torosky92/ChrisV2/Fotos - ChrisV2/Version 2/IMG-20191017-WA0040.jpg

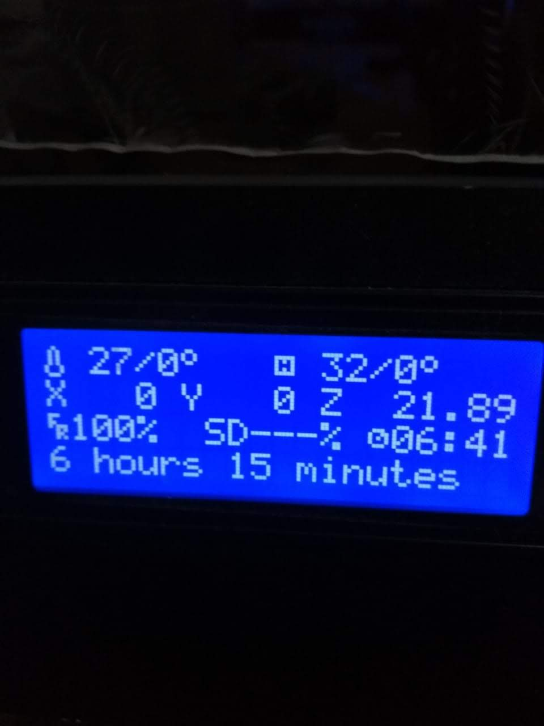
Fotos - ChrisV2/Version 2/IMG-20191017-WA0040.jpg
