torosky92/ChrisV2/Fotos - ChrisV2/Version 2/IMG-20191020-WA0022.jpg

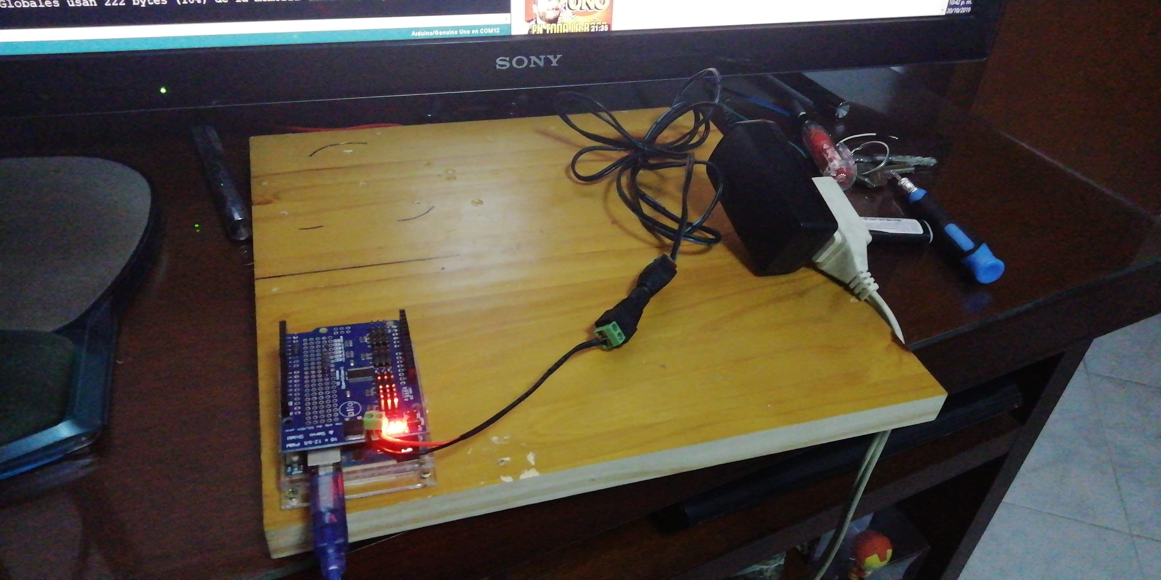
Fotos - ChrisV2/Version 2/IMG-20191020-WA0022.jpg
