torosky92/ChrisV2/Fotos - ChrisV2/Version 2/IMG_20191004_101258.jpg

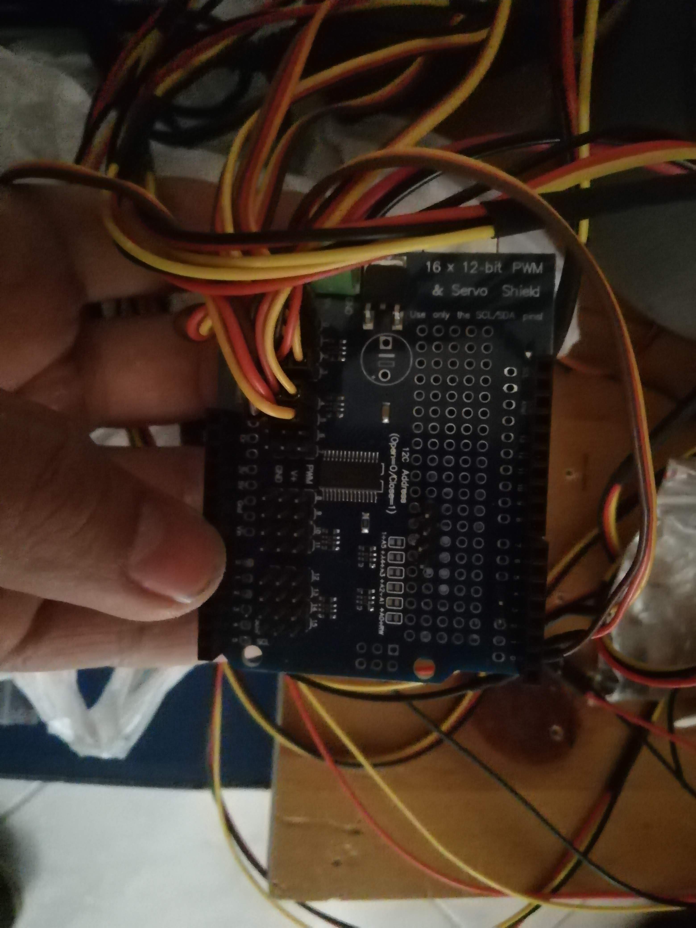
Fotos - ChrisV2/Version 2/IMG_20191004_101258.jpg
