torosky92/ChrisV2/Fotos - ChrisV2/Version 2/IMG_20191017_102911.jpg

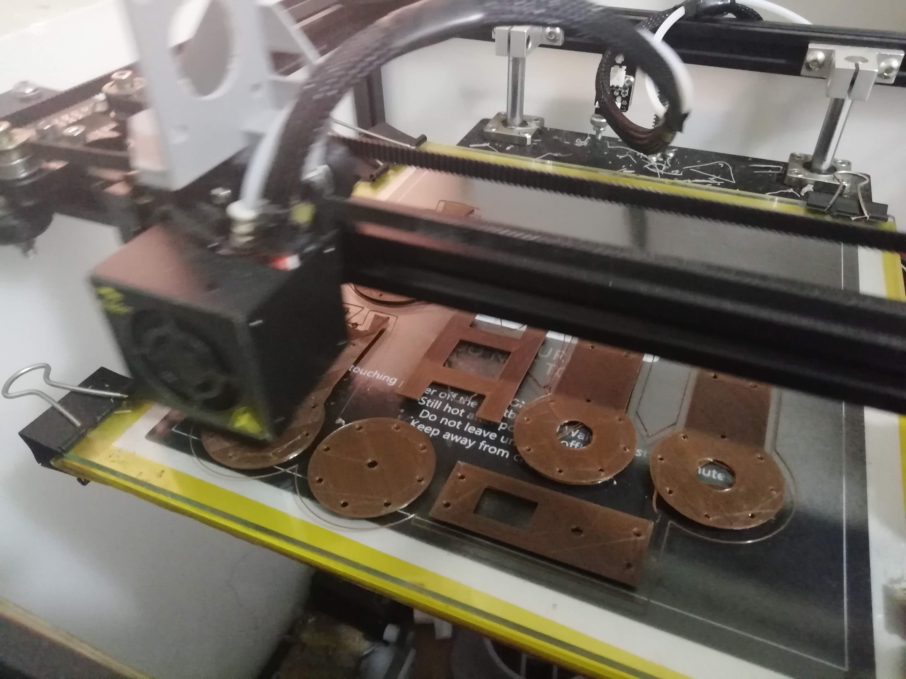
Fotos - ChrisV2/Version 2/IMG_20191017_102911.jpg
