torosky92/ChrisV2/Fotos - ChrisV2/Version 2/IMG_20191020_154016.jpg

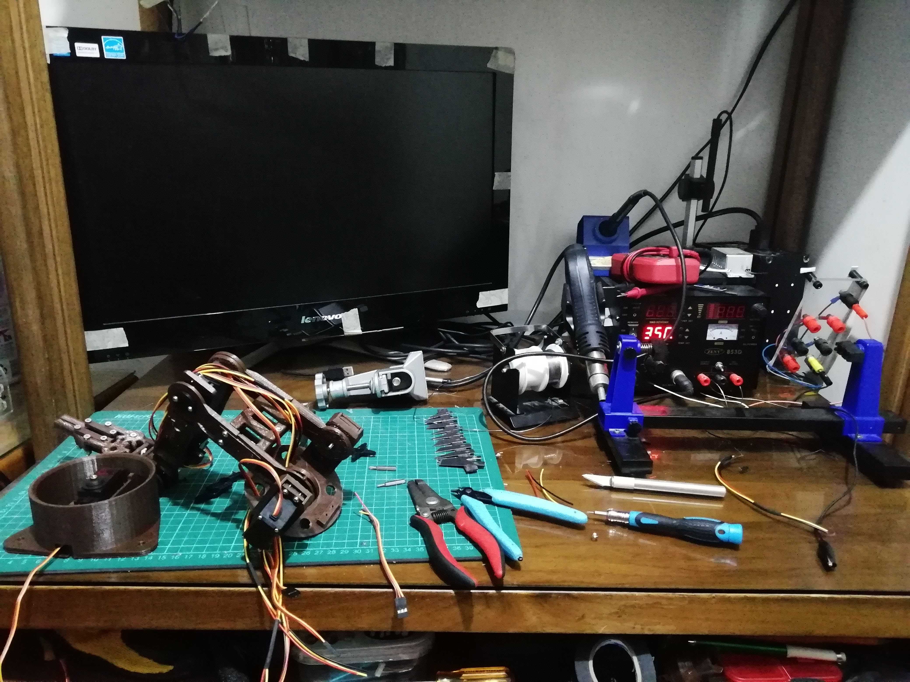
Fotos - ChrisV2/Version 2/IMG_20191020_154016.jpg
