torosky92/ChrisV2/Fotos - ChrisV2/Version 2/WhatsApp Image 2019-10-19 at 11.20.56 (1).jpeg

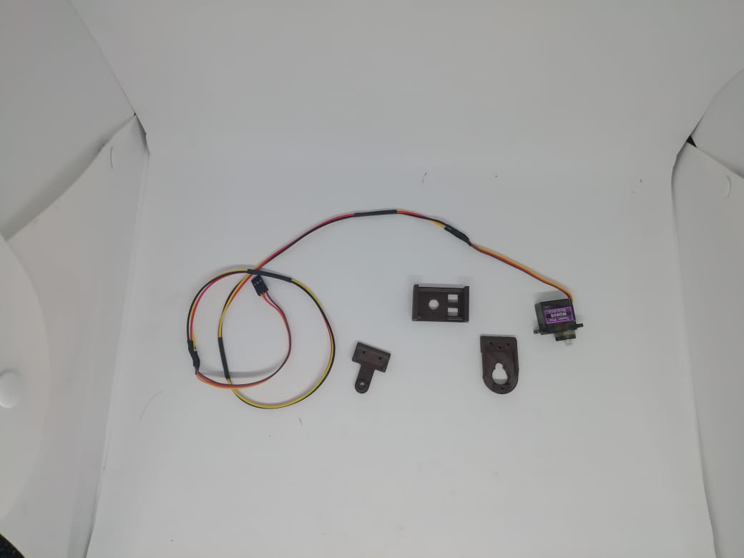
Fotos - ChrisV2/Version 2/WhatsApp Image 2019-10-19 at 11.20.56 (1).jpeg
