torosky92/ChrisV2/Fotos - ChrisV2/Version 2/WhatsApp Image 2019-10-19 at 11.21.00.jpeg

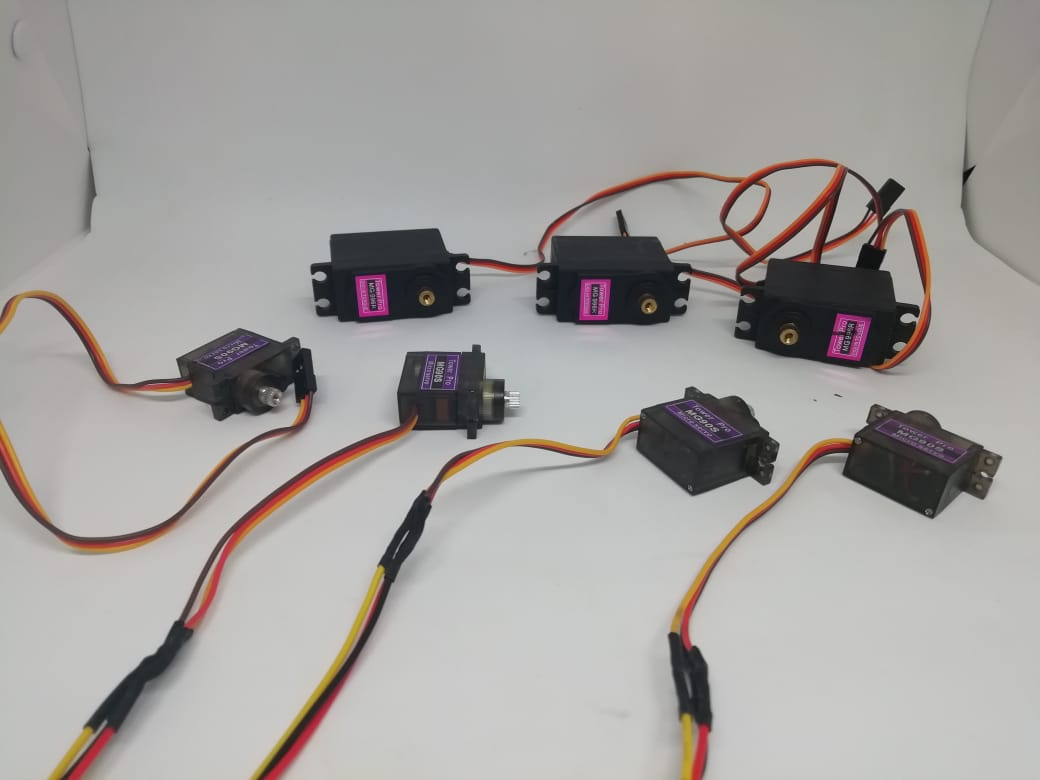
Fotos - ChrisV2/Version 2/WhatsApp Image 2019-10-19 at 11.21.00.jpeg
