torosky92/ChrisV2/Fotos - ChrisV2/Version 2/WhatsApp Image 2019-10-20 at 08.26.20 (2).jpeg

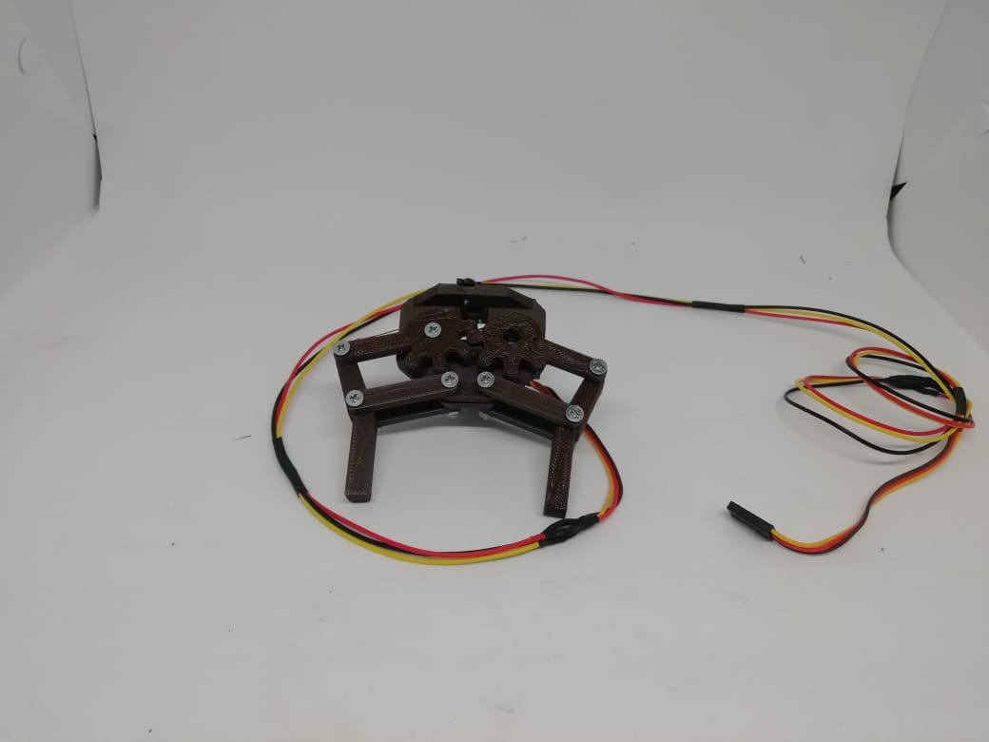
Fotos - ChrisV2/Version 2/WhatsApp Image 2019-10-20 at 08.26.20 (2).jpeg
