torosky92/ChrisV2/Fotos - ChrisV2/Version 2/WhatsApp Image 2019-10-24 at 18.39.17.jpeg

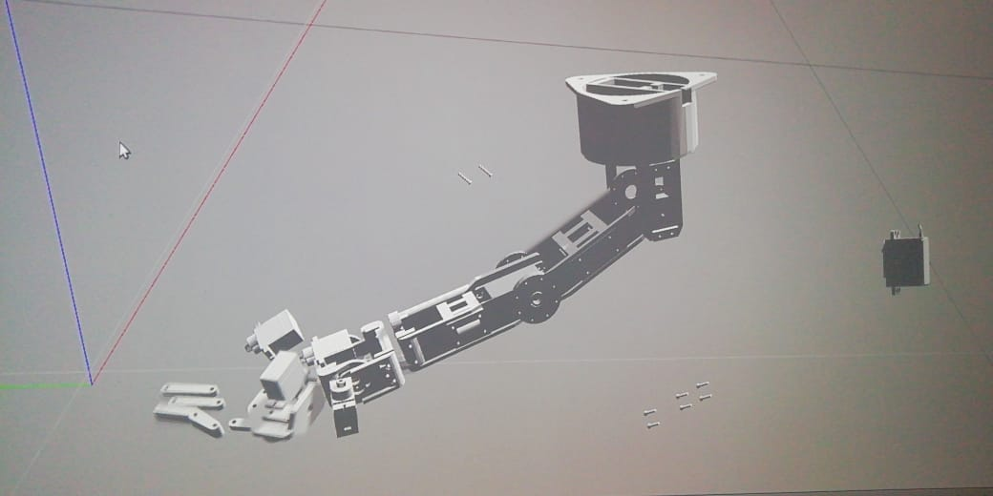
Fotos - ChrisV2/Version 2/WhatsApp Image 2019-10-24 at 18.39.17.jpeg
