torosky92/ChrisV2/Fotos - ChrisV2/Version 2/WhatsApp Image 2019-10-24 at 19.53.18.jpeg

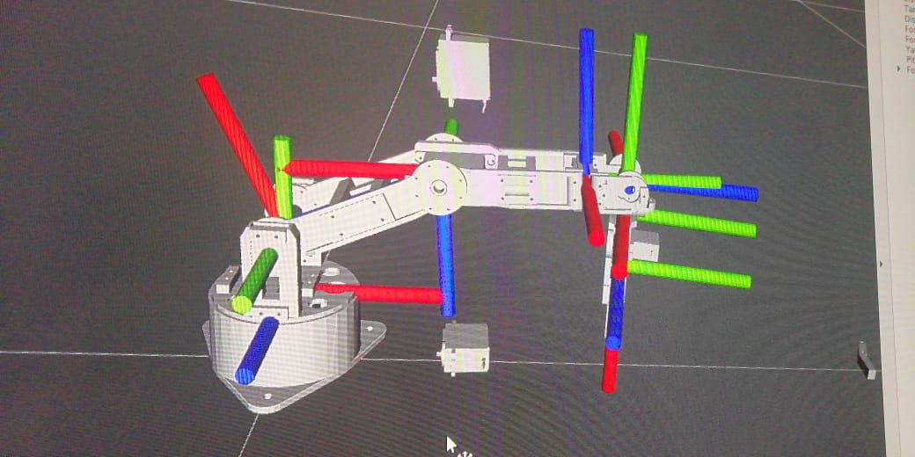
Fotos - ChrisV2/Version 2/WhatsApp Image 2019-10-24 at 19.53.18.jpeg
