torosky92/ChrisV2/Costo de Brazo 2019.xlsx

Sheet: Costo
COSTO DE BRAZO ROBOTICO CHRISTIAN
ARTICULO | CANT | VALOR U | VALOR TOTAL | Se tiene
Servomotor estandar de alto torque MG996R | 3 | $25000.00 | $75000.00 | X
Servomotor Mini MG90S | 5 | $15000.00 | $75000.00 | X
Servomotor Mini SG90 | 1 | $10000.00 | $10000.00 | X
Impresión 3d por hora y material | 31 | $4900.00 | $151900.00 | X
Tornillo de métrica M3x25mm | 10 | $60.00 | $600.00 | X
Tuerca de métrica M3 | 10 | $20.00 | $200.00 | X
Tornillo de métrica M2x6mm | 50 | $500.00 | $25000.00 | X
Tuerca de métrica M2 | 50 | $80.00 | $4000.00 | X
Cable amarillo AWG20 1m | 5 | $900.00 | $4500.00 | X
Cable rojo AWG20 1m | 5 | $900.00 | $4500.00 | X
Cable negro AWG20 1m | 5 | $900.00 | $4500.00 | X
Termo encogible 1m | 2 | $500.00 | $1000.00 | X
Shield para servomotores | 1 | $45000.00 | $45000.00 | X
Jack Chasis para voltaje DC 5*2.1mm | 1 | $600.00 | $600.00 | X
Arduino uno | 1 | $65000.00 | $65000.00 | X
Adaptador de voltaje 5V 3A | 1 | $13000.00 | $13000.00 | X
Header hembra 40 pines | 1 | $700.00 | $700.00 | X
Estaño | 1 | $5000.00 | $5000.00 | X
MDF 5mm de espesor 10cmX10cm | 1 | $10000.00 | $10000.00 | X
arandelas M3 | 1 | $500.00 | $500.00 | X
 |  | TOTAL | $496000.00

Sheet: Descripcion
CONTROL DEL BRAZO
VARIABLE | DESCRIPCIÓN | CONTROL | ARTICULACIÓN | LIMITES
 |  |  |  | RAD MIN | RAD MAX | FUERZA | VELOCIDAD
S1 | Giro de antebrazo con servo MG996R | ROS | 1 | 0 | 3.14 | 1000 | 0.5
S2 | Subir o Bajar de antebrazo con servo MG996R | ROS | 2 | -1.65 | 1.3 | 1000 | 0.5
S3 | Subir o Bajar de brazo con servo MG996R | ROS | 3 | -1.65 | 1.65 | 1000 | 0.5
S4 | Giro de brazo con servo MG90S | ROS | 4 | 0 | 3.14 | 1000 | 0.5
S5 | Subir o Bajar de Garra con servo MG90S | ROS | 5 | -1.5 | 1.5 | 1000 | 0.5
S6 | Giro de Garra con servo MG90S | ROS | 6 | 0 | 3.14 | 1000 | 0.5
S7 | Abrir o Cerrar la Garra con servo MG90S | ROS | 7 | -0.6 | 0 | 1000 | 0.5
S8 | Dispensador de las bolas de la rampa con servo SG90 | Arduino | 0 | 0 | 1.57 | 500 | 0.5
