torosky92/ChrisV2/SolidWorks/Ensamblaje-Eslabon5.SLDASM

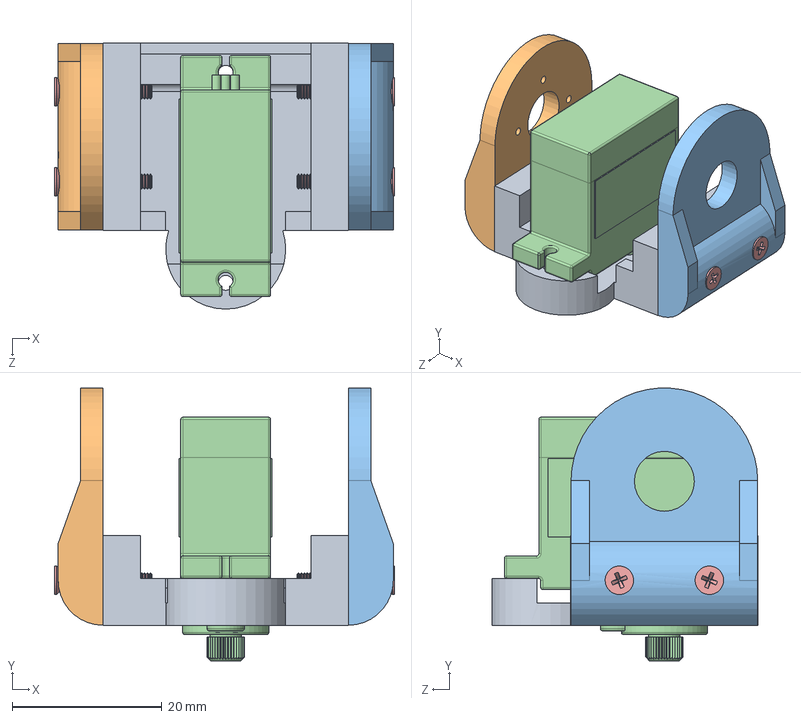
[picture p61: CAD file, 2020-05-09]
SolidWorks/Ensamblaje-Eslabon5.SLDASM
45.3 x 36.4 x 35.5 mm
Eslabon5A-Servo
Eslabon5B
Eslabon5C
MG90S-Servo
flat head screw_am x 4
