torosky92/ChrisV2/SolidWorks/Ensamblaje-Eslabon4.SLDASM

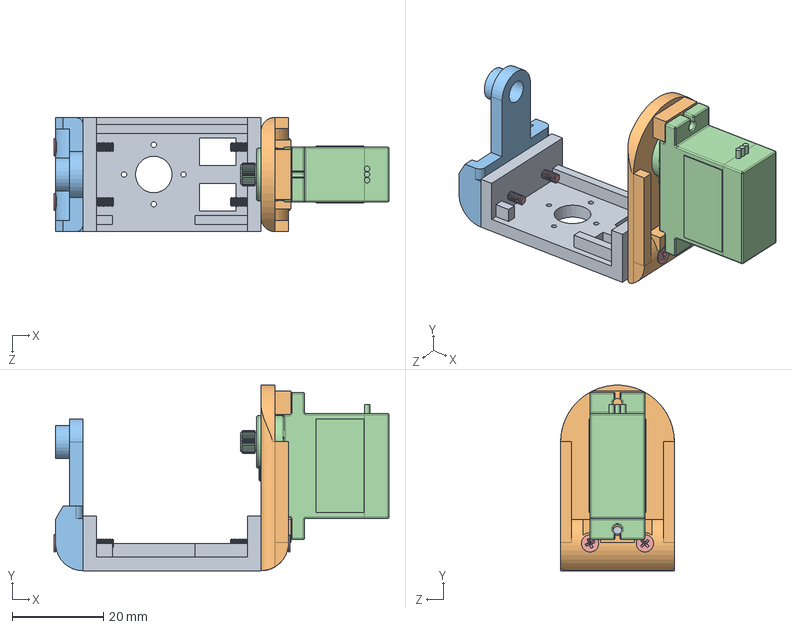
[picture p62: CAD file, 2020-05-09]
SolidWorks/Ensamblaje-Eslabon4.SLDASM
73.3 x 40.6 x 25.0 mm
Eslabon4A
Eslabon4B
Eslabon4C
MG90S-Servo
flat head screw_am x 4
