torosky92/ChrisV2/SolidWorks/Ensamblaje-Eslabon2AB.SLDASM

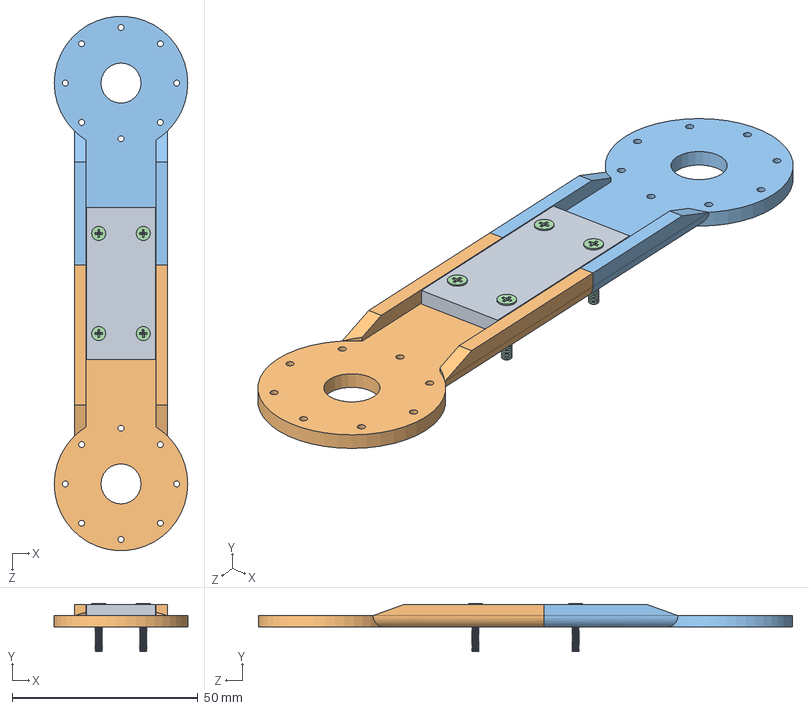
[picture p63: CAD file, 2020-05-09]
SolidWorks/Ensamblaje-Eslabon2AB.SLDASM
36.0 x 13.0 x 143.9 mm
Agarre-Eslabon2AyB
Eslabon2A
Eslabon2B
flat head screw_am x 4
