torosky92/ChrisV2/SolidWorks/Ensamblaje-Garra.SLDASM

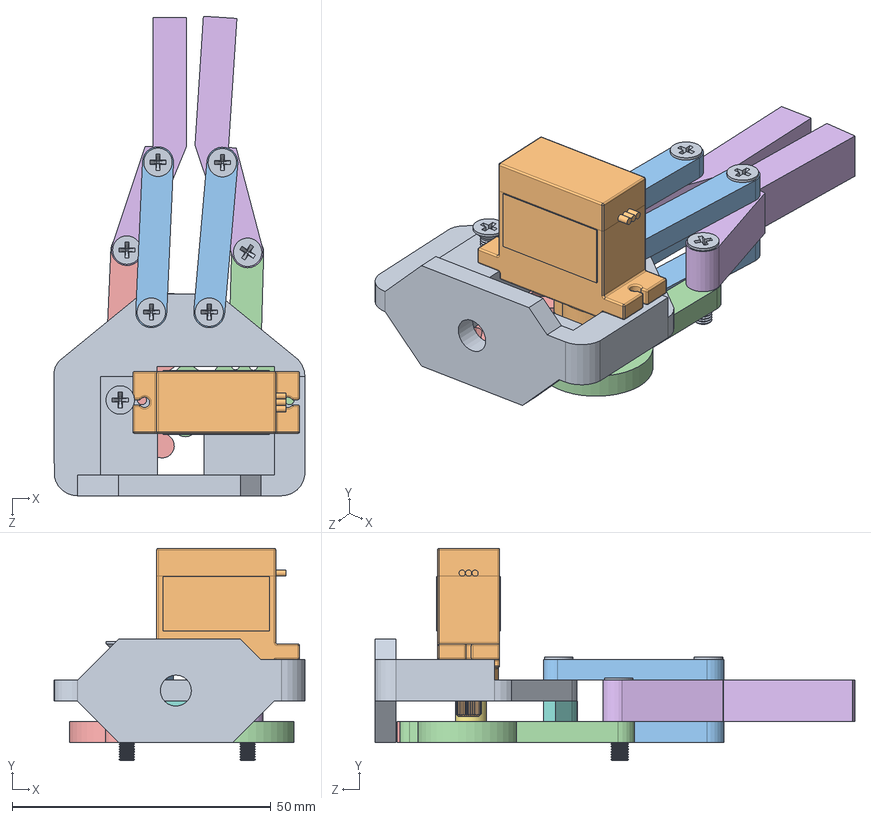
[picture p64: CAD file, 2020-05-09]
SolidWorks/Ensamblaje-Garra.SLDASM
48.5 x 41.0 x 92.7 mm
Base-De-Garra
MG90S-Servo
Conector-Garra1 x 4
Engranaje2-Garra
Engranaje-Garra
Pinza-Garra x 2
Separador-Engrane-Base
Soporte-Garra
flat head screw_am x 7
