torosky92/ChrisV2/SolidWorks/Ensamblaje-Eslabon2.SLDASM

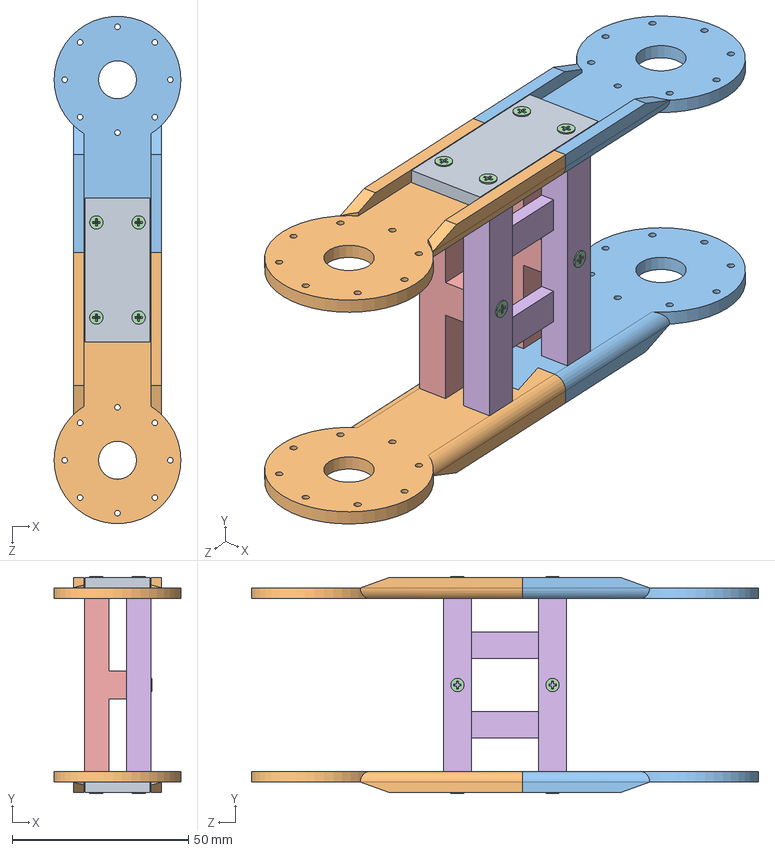
[picture p65: CAD file, 2020-05-09]
SolidWorks/Ensamblaje-Eslabon2.SLDASM
36.0 x 61.7 x 143.9 mm
Agarre-Eslabon2AyB x 2
Eslabon2A x 2
Eslabon2B x 2
flat head screw_am x 10
Conexion-Eslabones2
Conexion-Eslabones22
