torosky92/ChrisV2/SolidWorks/Ensamblaje-Eslabon1.SLDASM

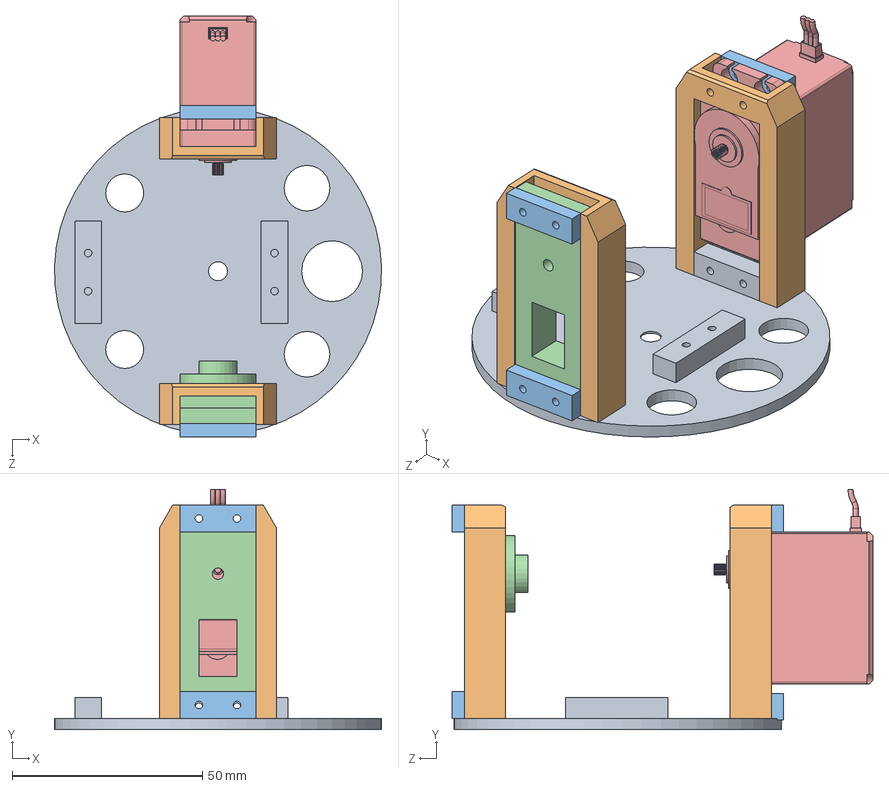
[picture p66: CAD file, 2020-05-09]
SolidWorks/Ensamblaje-Eslabon1.SLDASM
85.9 x 63.2 x 110.6 mm
Tapa-Base
Agarre-Servo1 x 2
Anclaje-Servo1 x 4
Soporte-Tama-Servo
MG996R-Servo
