torosky92/ChrisV2/SolidWorks/Ensamblaje-Eslabon3.SLDASM

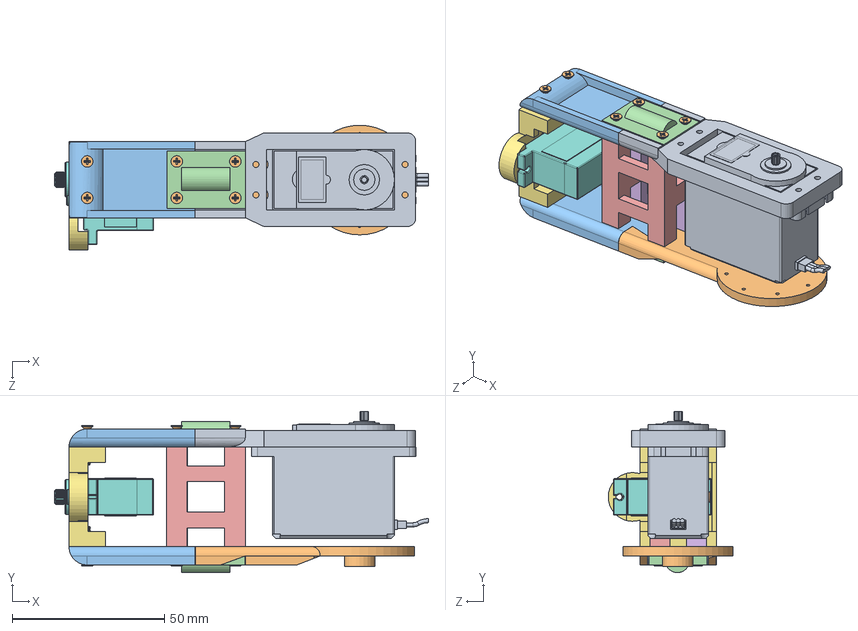
[picture p67: CAD file, 2020-05-09]
SolidWorks/Ensamblaje-Eslabon3.SLDASM
122.8 x 53.0 x 40.9 mm
Eslabon3A-Servo
Eslabon3B
Eslabon3C x 2
Eslabon3D x 2
Eslabon3E1
Eslabon3E2
Eslabon3F-Servo
MG90S-Servo
MG996R-Servo
flat head screw_am x 14
