torosky92/ChrisV2/SolidWorks/Ensamblaje-Base.SLDASM

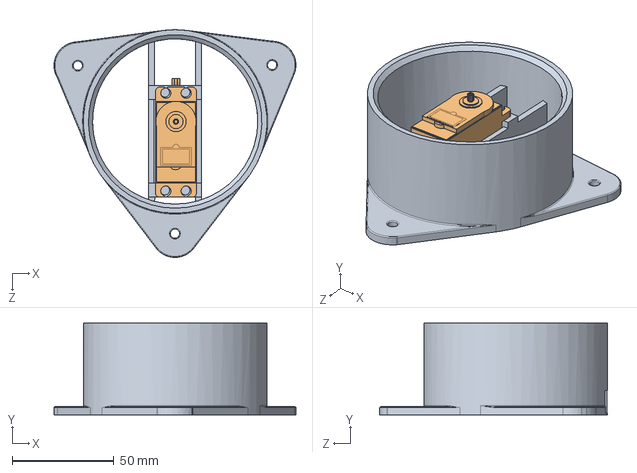
[picture p68: CAD file, 2020-05-09]
SolidWorks/Ensamblaje-Base.SLDASM
118.6 x 45.0 x 111.6 mm
BaseBrazoMG995
MG996R-Servo
