torosky92/ChrisV2/SolidWorks/Ensamblaje-Final.SLDASM

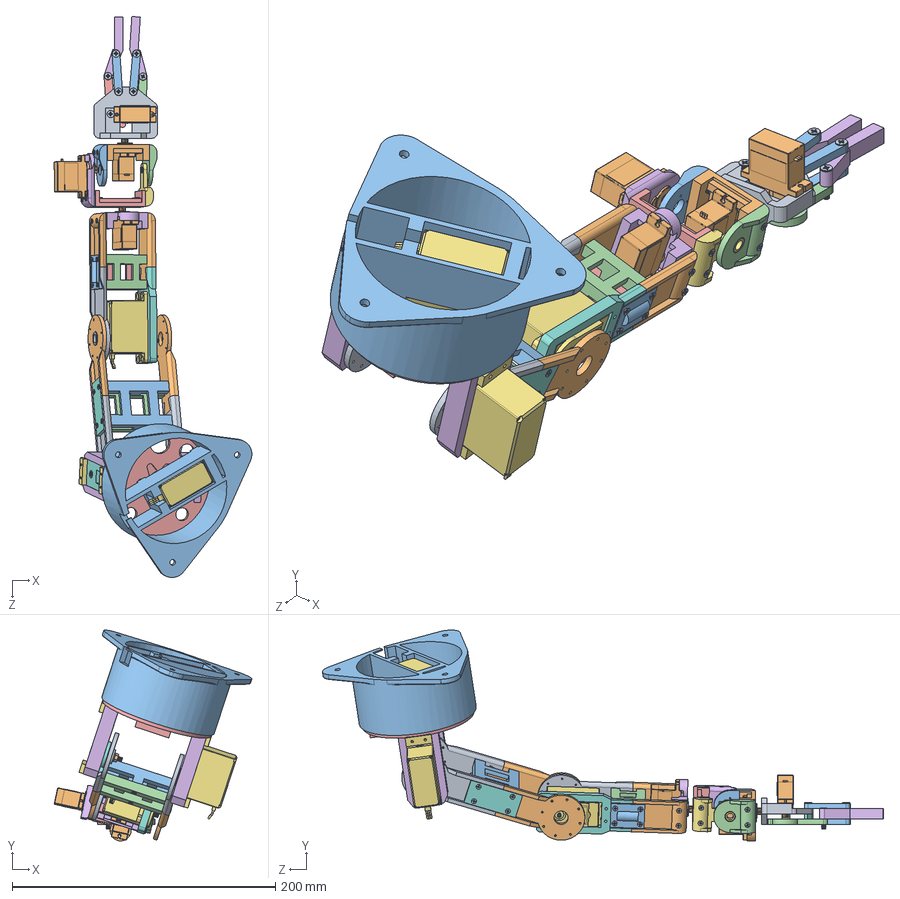
[picture p69: CAD file, 2020-05-09]
SolidWorks/Ensamblaje-Final.SLDASM
150.3 x 160.4 x 426.6 mm
Base-De-Garra
MG90S-Servo x 4
Conector-Garra1 x 4
Engranaje2-Garra
Engranaje-Garra
Pinza-Garra x 2
Separador-Engrane-Base
Soporte-Garra
flat head screw_am x 40
Eslabon5A-Servo
Eslabon5B
Eslabon5C
Eslabon4A
Eslabon4B
Eslabon4C
Eslabon3A-Servo
Eslabon3B
Eslabon3C x 2
Eslabon3D x 2
Eslabon3E1
Eslabon3E2
Eslabon3F-Servo
MG996R-Servo x 3
Agarre-Eslabon2AyB x 2
Eslabon2A x 2
Eslabon2B x 2
Conexion-Eslabones2
Conexion-Eslabones22
Tapa-Base
Agarre-Servo1 x 2
Anclaje-Servo1 x 4
Soporte-Tama-Servo
flat washer narrow_am x 2
hex nut style 1_am
BaseBrazoMG995
