torosky92/ChrisV2/arm6/meshes/link1.STL

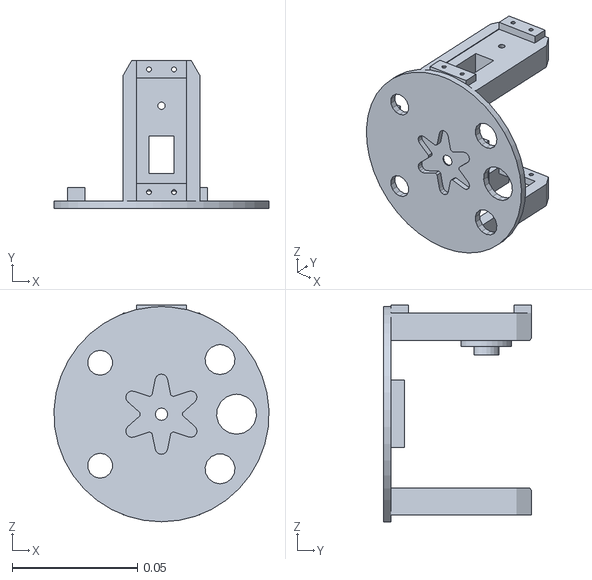
[picture p70: CAD file, 2020-05-09]
arm6/meshes/link1.STL
0.0859 x 0.059 x 0.0865
