torosky92/ChrisV2/Codigo ROS/Control_ws/install/share/arm6/meshes/link3.STL

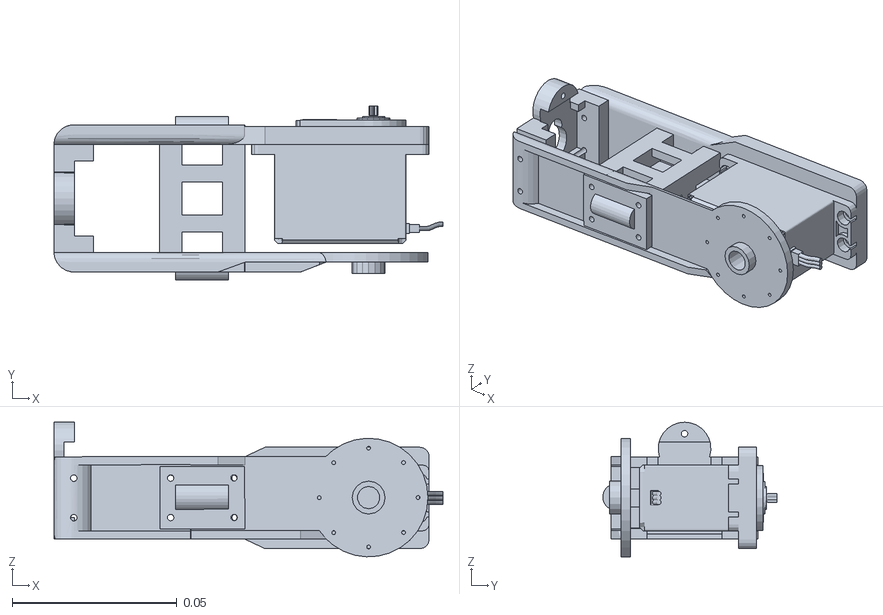
[picture p71: CAD file, 2020-05-09]
Codigo ROS/Control_ws/install/share/arm6/meshes/link3.STL
0.118 x 0.0529 x 0.0409
