torosky92/ChrisV2/Codigo ROS/Control_ws/src/arm6/meshes/link7.STL

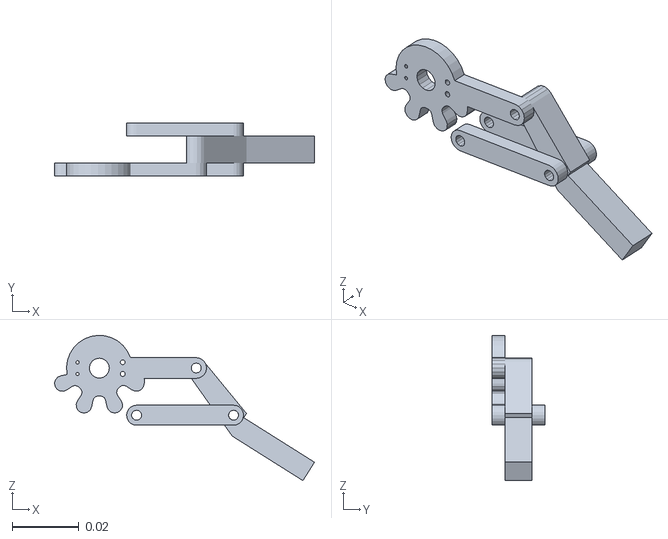
[picture p72: CAD file, 2020-05-09]
Codigo ROS/Control_ws/src/arm6/meshes/link7.STL
0.0778 x 0.016 x 0.0435
