torosky92/ChrisV2/SolidWorks/BaseBrazoMG995.SLDPRT

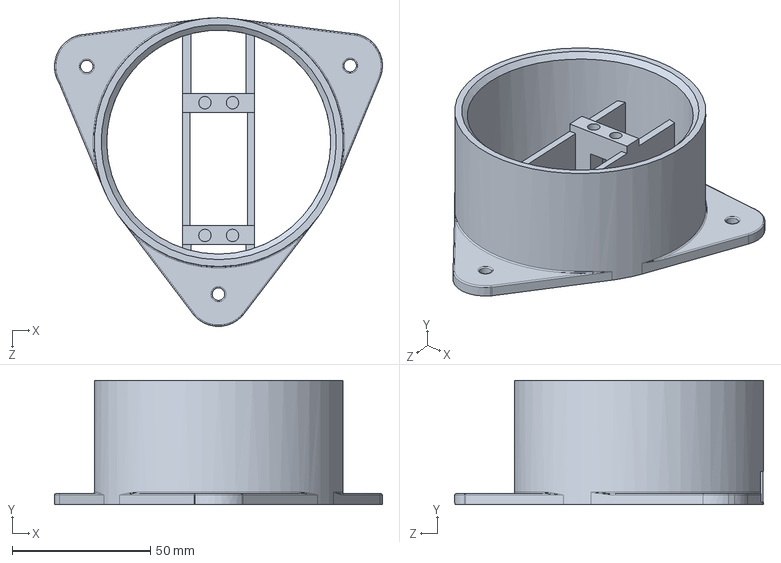
[picture p73: CAD file, 2020-05-09]
SolidWorks/BaseBrazoMG995.SLDPRT
118.6 x 45.0 x 111.6 mm
