torosky92/ChrisV2/SolidWorks/Electronica/MG90S-Servo.SLDPRT

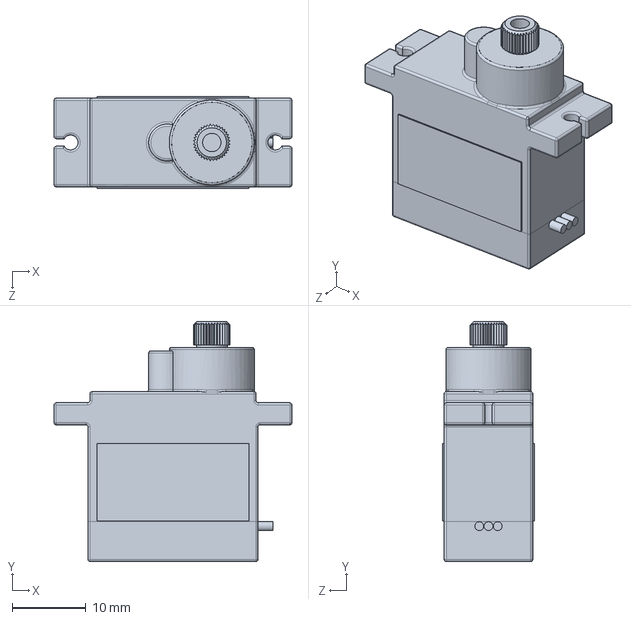
[picture p74: CAD file, 2020-05-09]
SolidWorks/Electronica/MG90S-Servo.SLDPRT
32.2 x 32.5 x 12.4 mm
