torosky92/ChrisV2/arm6/meshes/link6.STL

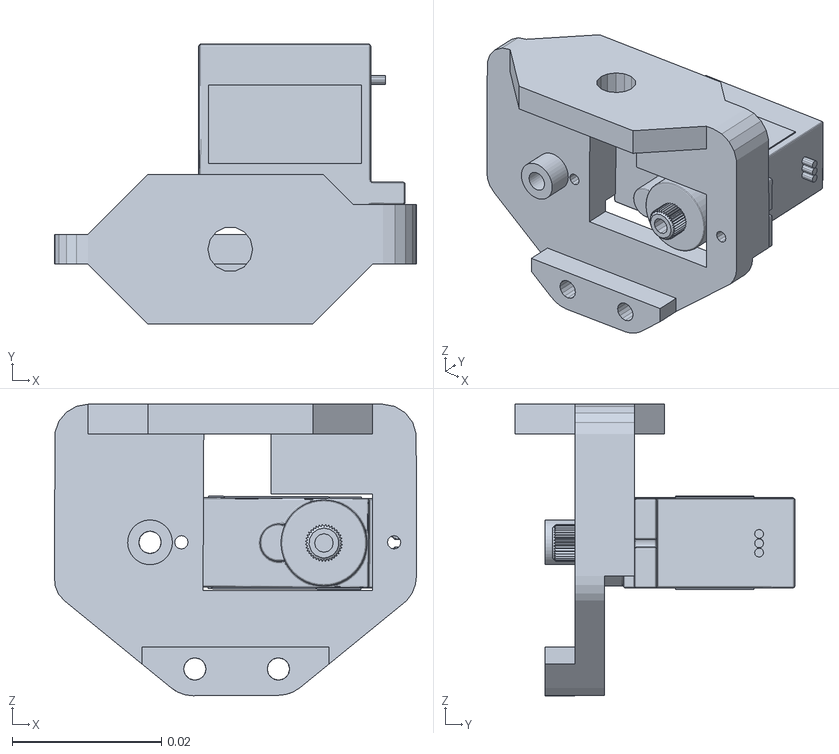
[picture p75: CAD file, 2020-05-09]
arm6/meshes/link6.STL
0.0485 x 0.0375 x 0.0391
