torosky92/ChrisV2/Codigo ROS/Control_ws/install/share/arm6/meshes/link2.STL

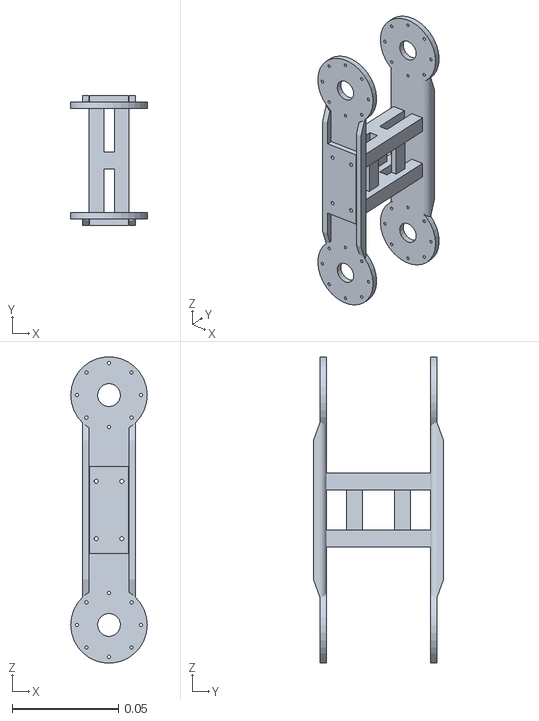
[picture p76: CAD file, 2020-05-09]
Codigo ROS/Control_ws/install/share/arm6/meshes/link2.STL
0.036 x 0.0611 x 0.144
