torosky92/ChrisV2/Codigo ROS/Control_ws/src/arm6/meshes/link5.STL

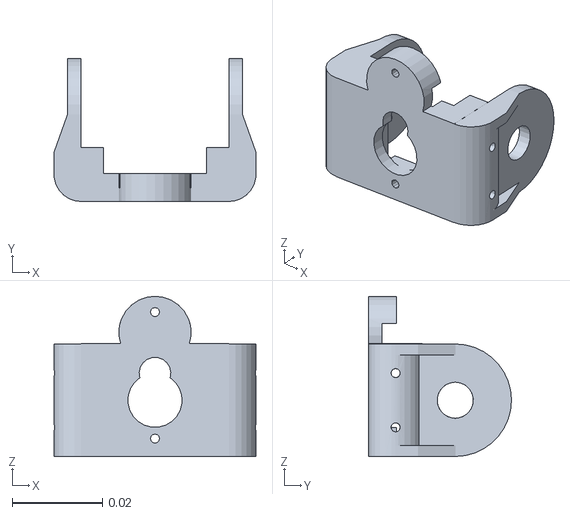
[picture p77: CAD file, 2020-05-09]
Codigo ROS/Control_ws/src/arm6/meshes/link5.STL
0.0447 x 0.0316 x 0.0355
