torosky92/ChrisV2/SolidWorks/Electronica/MG996R-Servo.SLDPRT

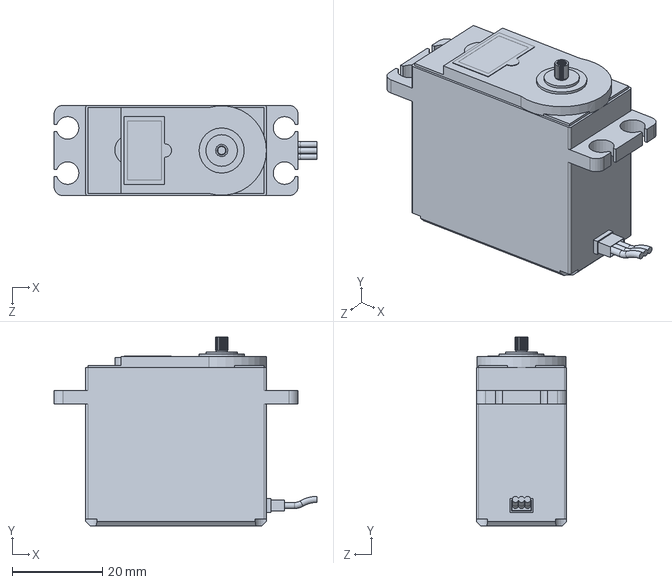
[picture p78: CAD file, 2020-05-09]
SolidWorks/Electronica/MG996R-Servo.SLDPRT
58.2 x 41.8 x 20.0 mm
