torosky92/ChrisV2/arm6/meshes/base_link.STL

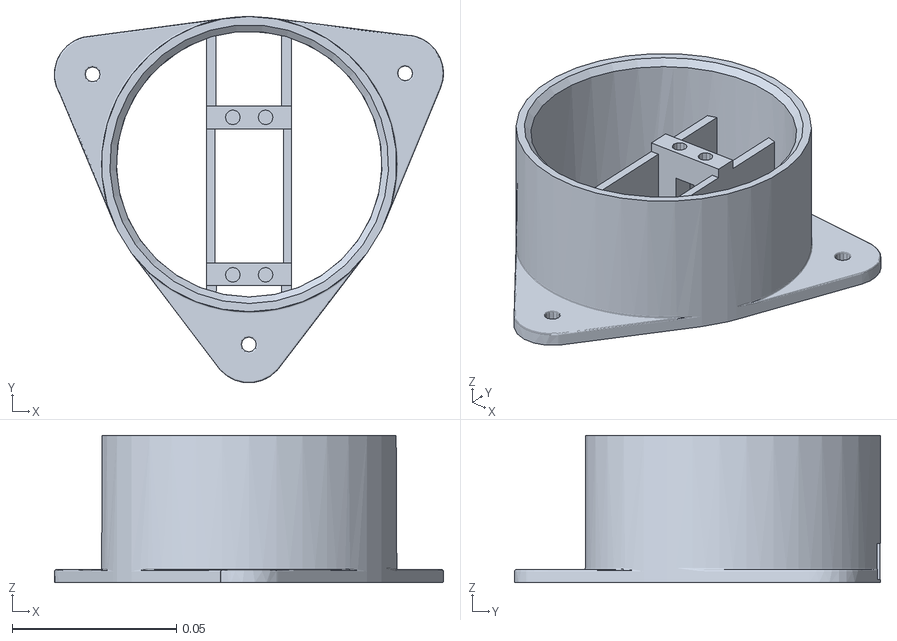
[picture p80: CAD file, 2020-05-09]
arm6/meshes/base_link.STL
0.119 x 0.112 x 0.045
