torosky92/ChrisV2/SolidWorks/Anclaje-Servo1.SLDPRT

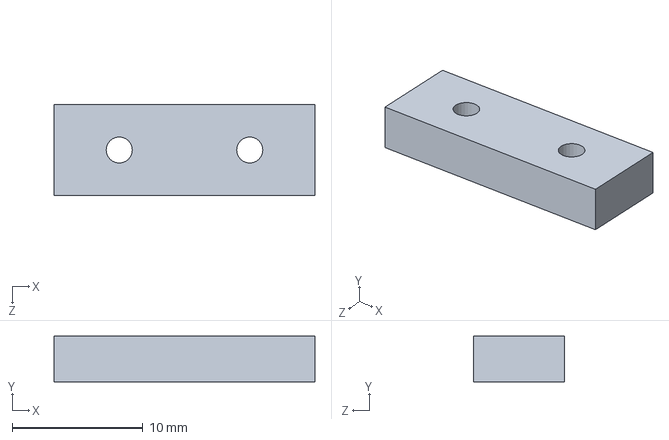
[picture p81: CAD file, 2020-05-09]
SolidWorks/Anclaje-Servo1.SLDPRT
20.0 x 3.50 x 7.00 mm
