torosky92/ChrisV2/Codigo ROS/Control_ws/install/share/arm6/meshes/link4.STL

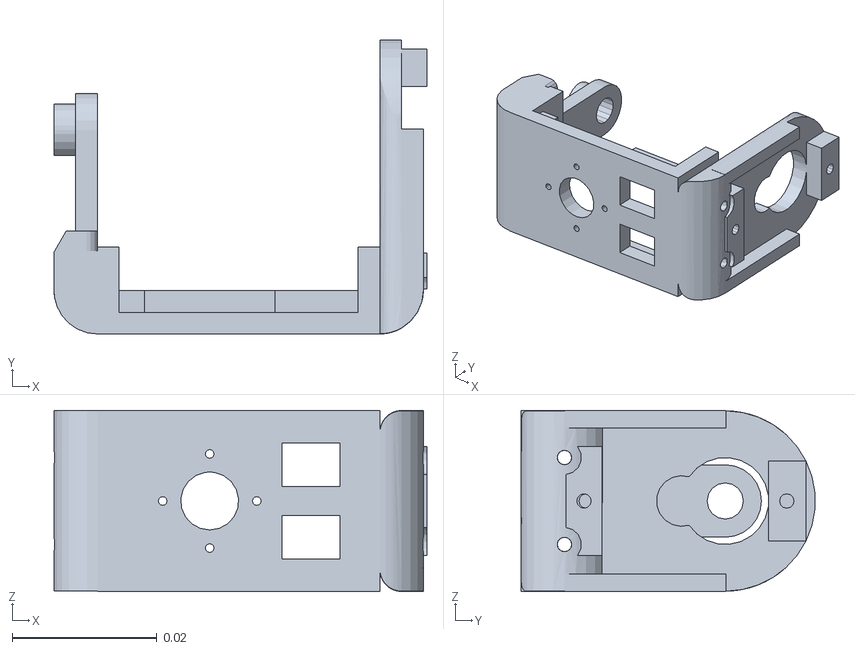
[picture p82: CAD file, 2020-05-09]
Codigo ROS/Control_ws/install/share/arm6/meshes/link4.STL
0.0515 x 0.0406 x 0.025
