torosky92/ChrisV2/SolidWorks/Pinza-Garra.SLDPRT

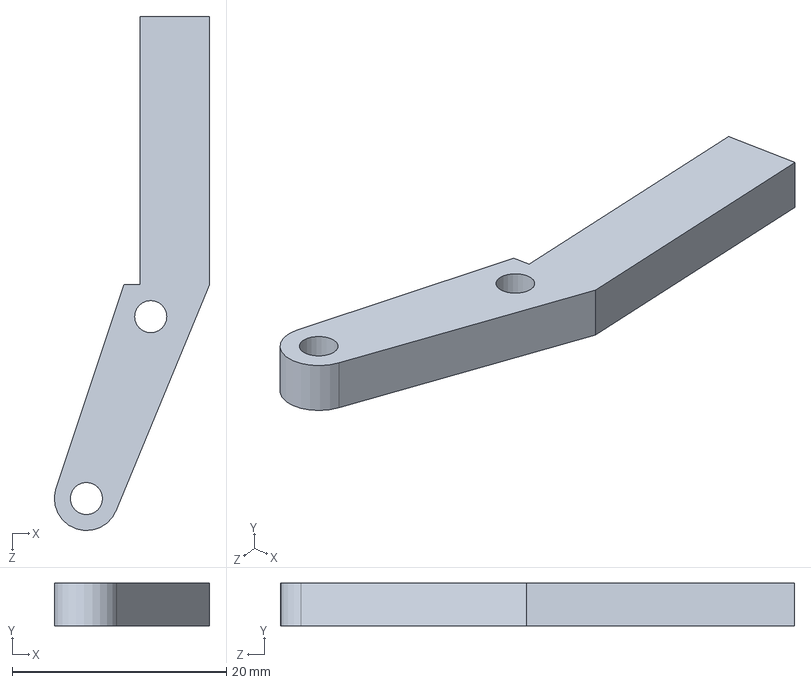
[picture p83: CAD file, 2020-05-09]
SolidWorks/Pinza-Garra.SLDPRT
14.5 x 4.00 x 48.0 mm
