torosky92/ChrisV2/SolidWorks/Eslabon5B.SLDPRT

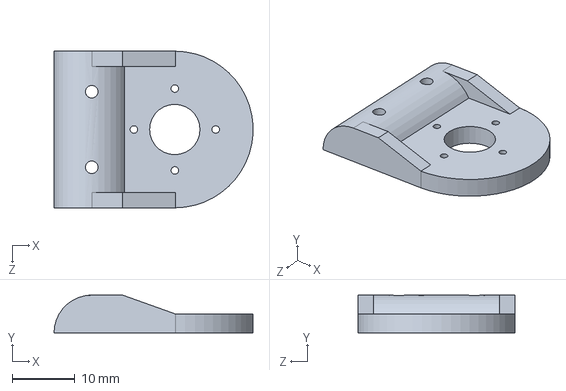
[picture p84: CAD file, 2020-05-09]
SolidWorks/Eslabon5B.SLDPRT
31.6 x 6.00 x 24.9 mm
