torosky92/ChrisV2/SolidWorks/Agarre-Eslabon2AyB.SLDPRT

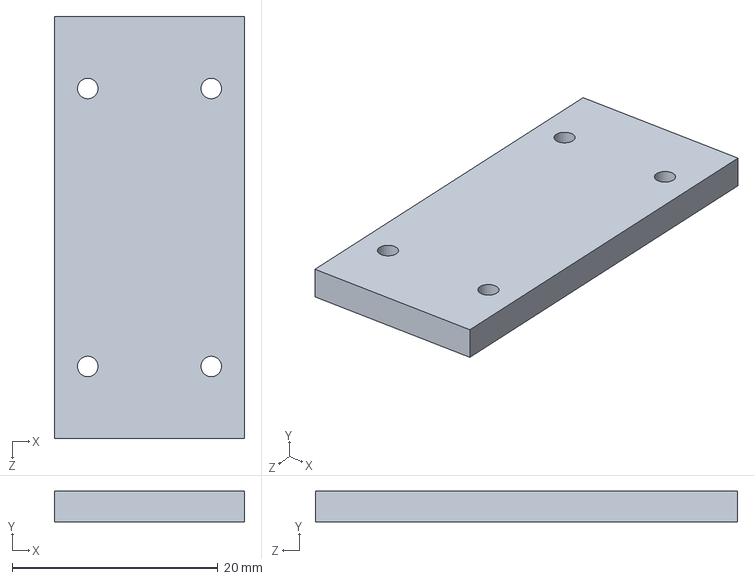
[picture p85: CAD file, 2020-05-09]
SolidWorks/Agarre-Eslabon2AyB.SLDPRT
18.5 x 3.00 x 41.0 mm
