torosky92/ChrisV2/SolidWorks/Eslabon3F-Servo.SLDPRT

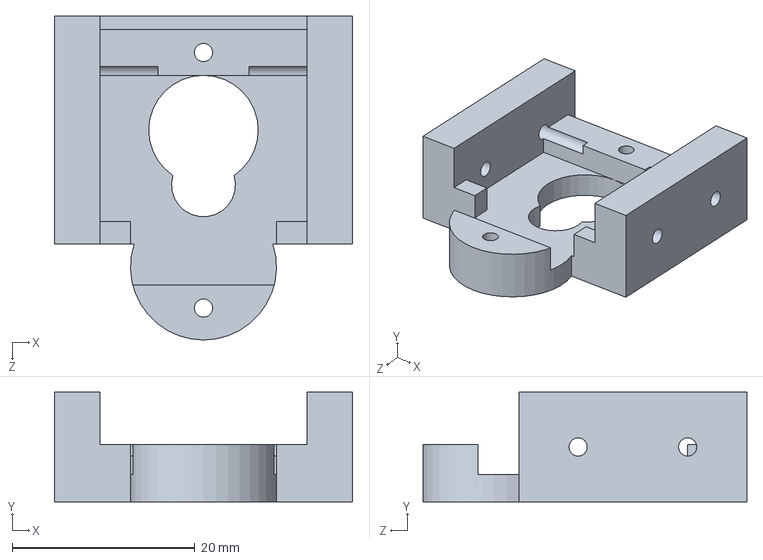
[picture p86: CAD file, 2020-05-09]
SolidWorks/Eslabon3F-Servo.SLDPRT
32.7 x 12.0 x 35.5 mm
