torosky92/ChrisV2/arm6/meshes/link8.STL

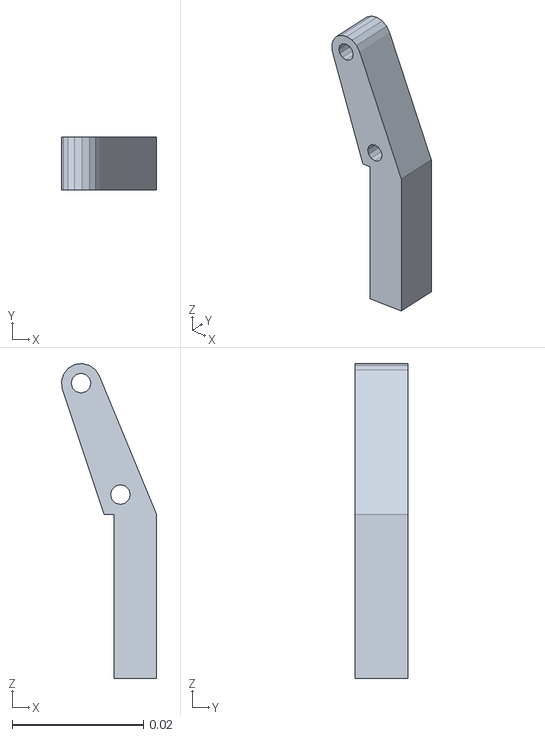
[picture p87: CAD file, 2020-05-09]
arm6/meshes/link8.STL
0.0145 x 0.008 x 0.048
