torosky92/ChrisV2/SolidWorks/Tapa-Base.SLDPRT

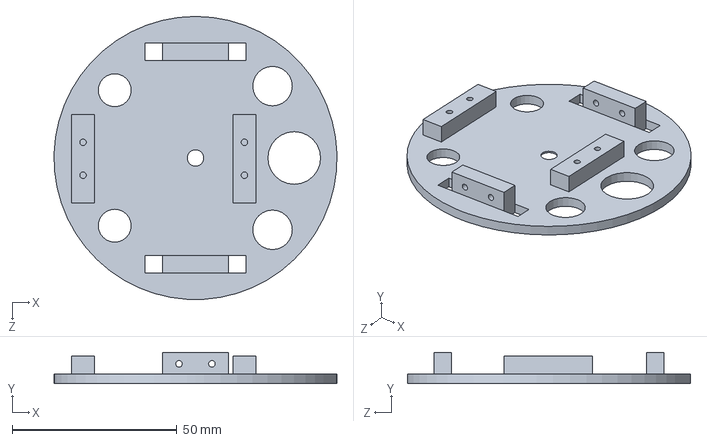
[picture p88: CAD file, 2020-05-09]
SolidWorks/Tapa-Base.SLDPRT
85.9 x 9.50 x 86.0 mm
