torosky92/ChrisV2/SolidWorks/Separador-Engrane-Base.SLDPRT

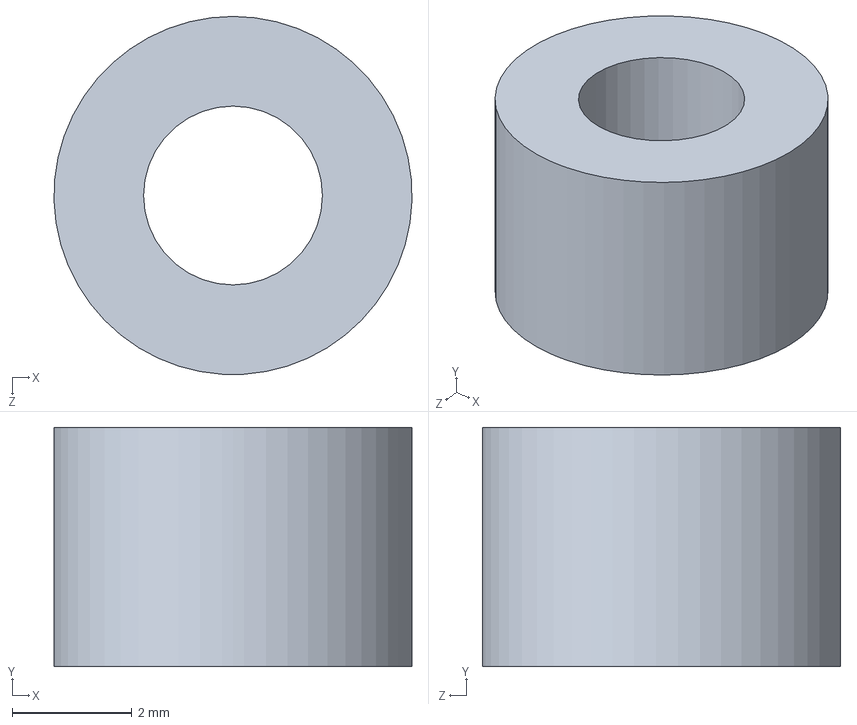
[picture p89: CAD file, 2020-05-09]
SolidWorks/Separador-Engrane-Base.SLDPRT
5.99 x 4.00 x 5.99 mm
