torosky92/ChrisV2/SolidWorks/Eslabon3E2.SLDPRT

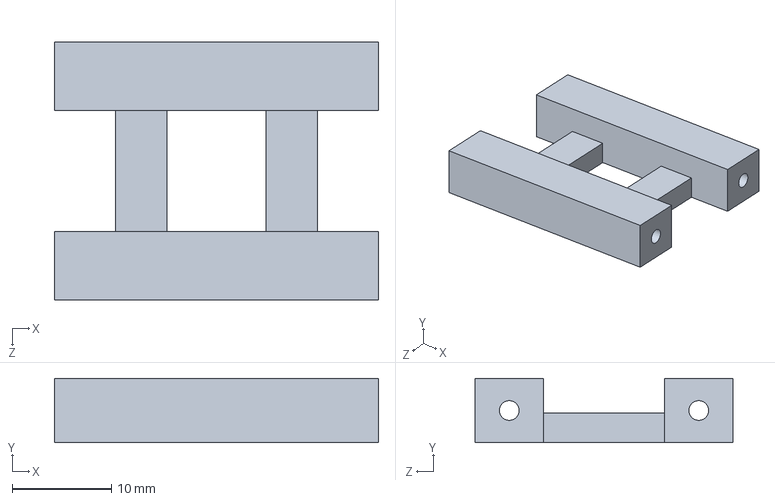
[picture p90: CAD file, 2020-05-09]
SolidWorks/Eslabon3E2.SLDPRT
32.7 x 6.50 x 26.0 mm
