torosky92/ChrisV2/SolidWorks/Eslabon3D.SLDPRT

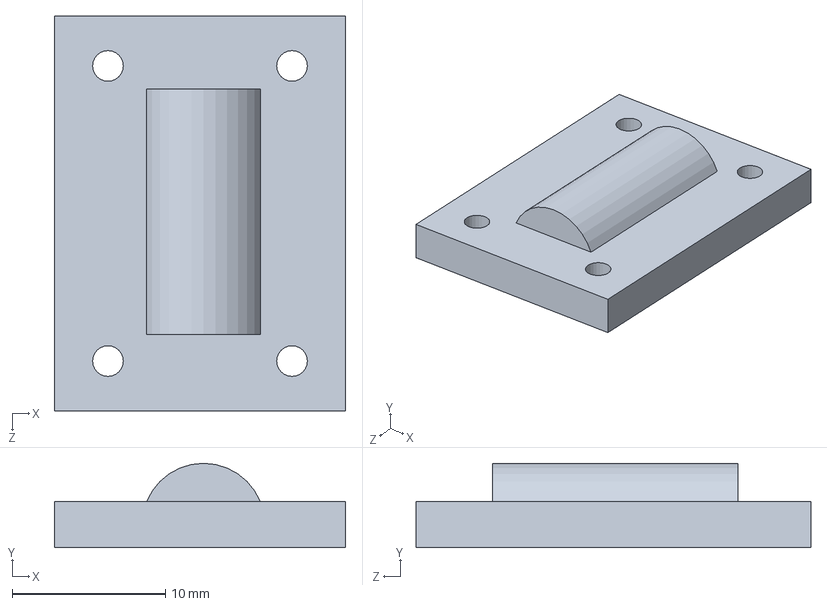
[picture p91: CAD file, 2020-05-09]
SolidWorks/Eslabon3D.SLDPRT
19.0 x 5.50 x 25.8 mm
