torosky92/ChrisV2/SolidWorks/Eslabon4A.SLDPRT

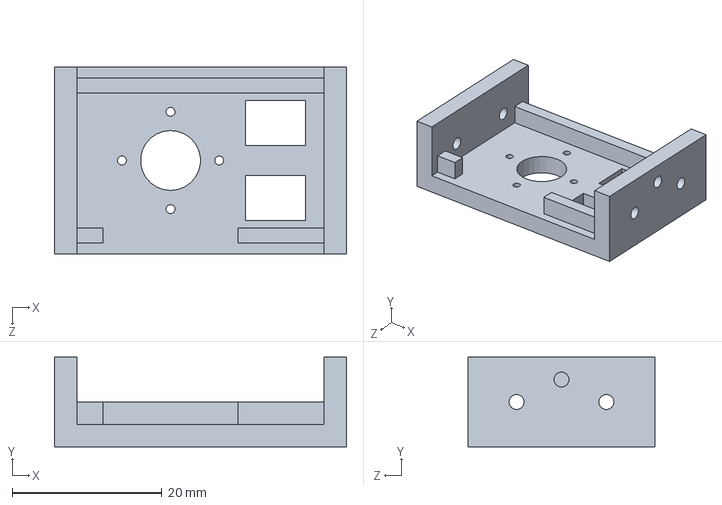
[picture p92: CAD file, 2020-05-09]
SolidWorks/Eslabon4A.SLDPRT
39.0 x 12.0 x 25.0 mm
