torosky92/ChrisV2/SolidWorks/Base-De-Garra.SLDPRT

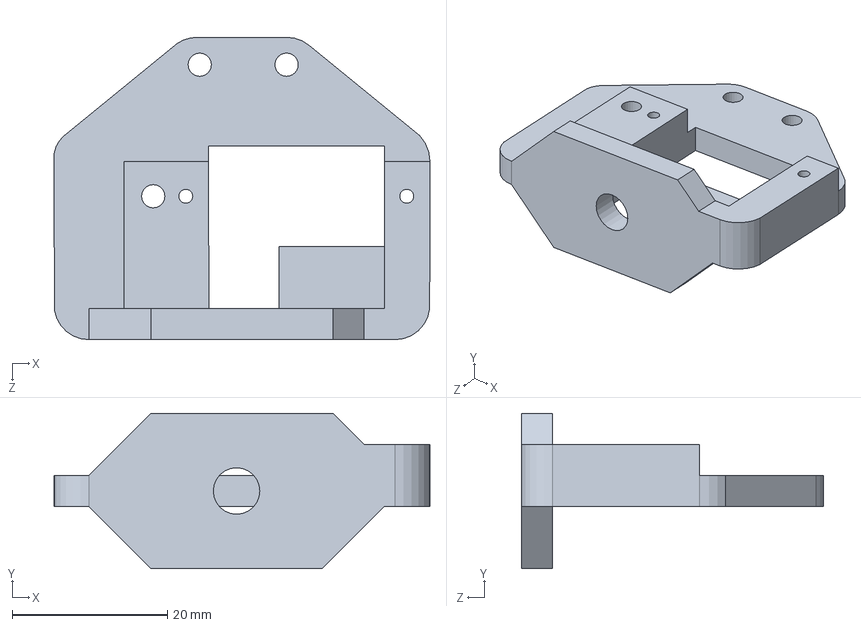
[picture p93: CAD file, 2020-05-09]
SolidWorks/Base-De-Garra.SLDPRT
48.5 x 20.0 x 39.0 mm
