torosky92/ChrisV2/SolidWorks/Conexion-Eslabones22.SLDPRT

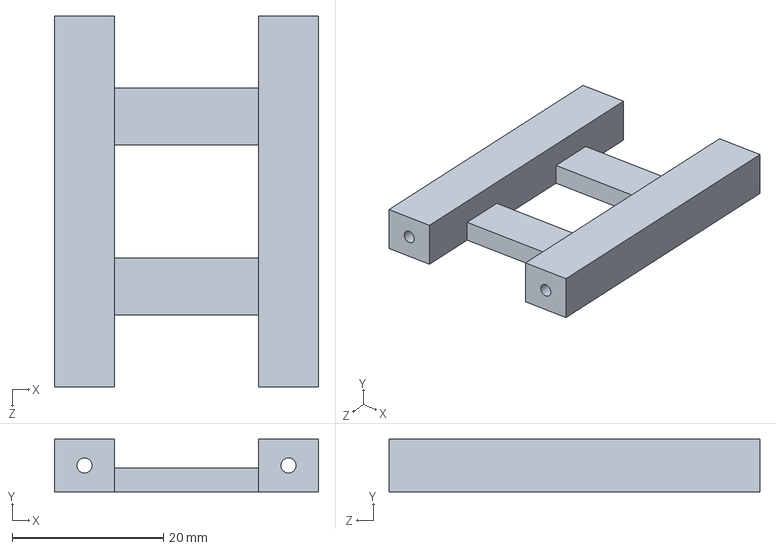
[picture p94: CAD file, 2020-05-09]
SolidWorks/Conexion-Eslabones22.SLDPRT
35.0 x 7.00 x 49.1 mm
