torosky92/ChrisV2/SolidWorks/Conector-Garra1.SLDPRT

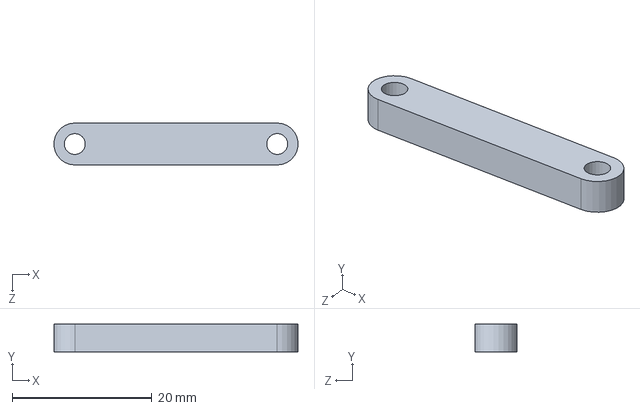
[picture p95: CAD file, 2020-05-09]
SolidWorks/Conector-Garra1.SLDPRT
35.0 x 4.00 x 6.00 mm
