torosky92/ChrisV2/SolidWorks/Eslabon3A-Servo.SLDPRT

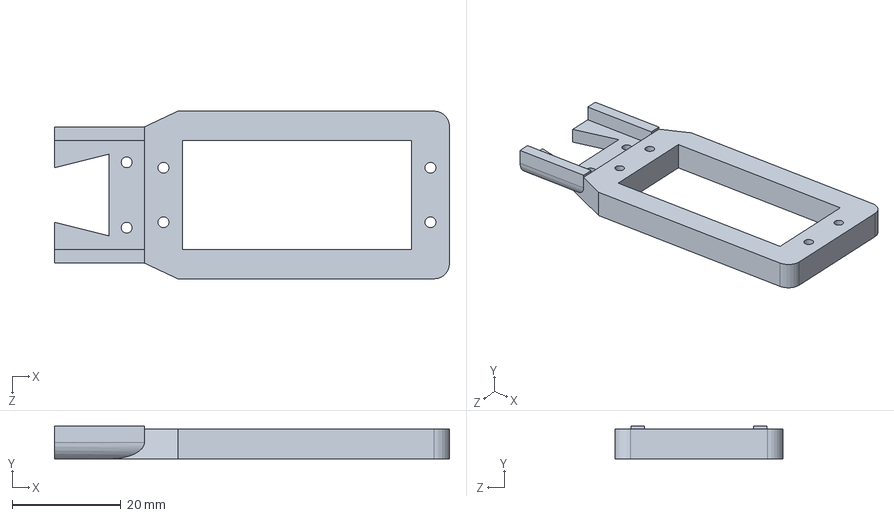
[picture p96: CAD file, 2020-05-09]
SolidWorks/Eslabon3A-Servo.SLDPRT
72.5 x 6.00 x 30.8 mm
