torosky92/ChrisV2/SolidWorks/Eslabon3B.SLDPRT

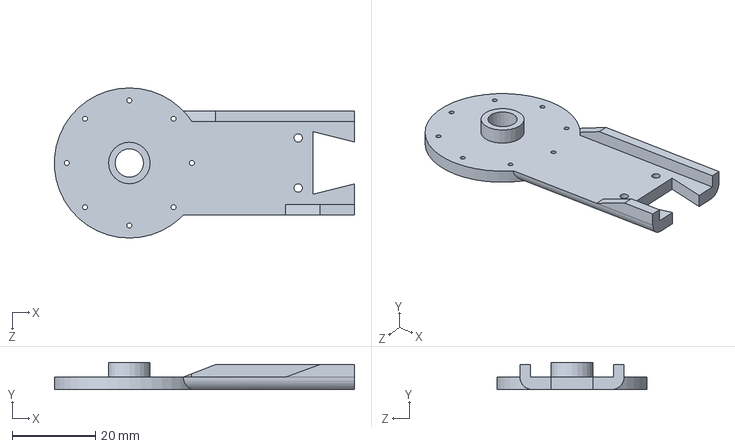
[picture p97: CAD file, 2020-05-09]
SolidWorks/Eslabon3B.SLDPRT
72.0 x 6.50 x 36.0 mm
