torosky92/ChrisV2/SolidWorks/Agarre-Servo1.SLDPRT

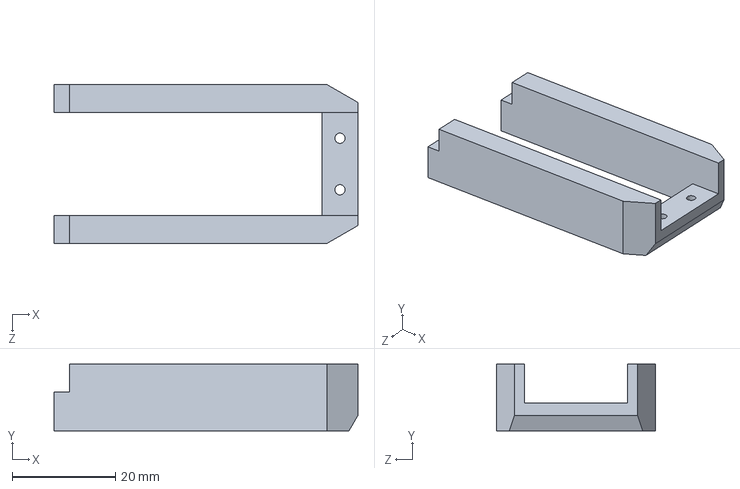
[picture p98: CAD file, 2020-05-09]
SolidWorks/Agarre-Servo1.SLDPRT
59.0 x 13.0 x 30.8 mm
