torosky92/ChrisV2/SolidWorks/Soporte-Tama-Servo.SLDPRT

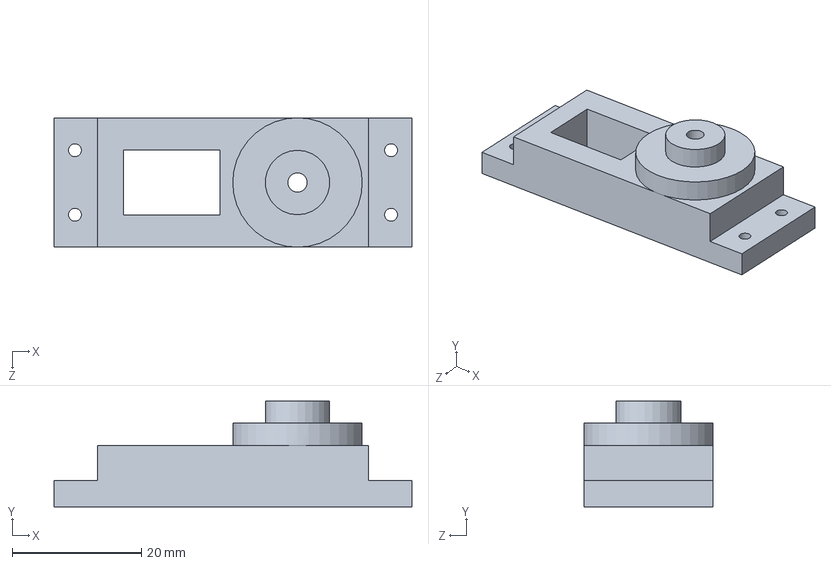
[picture p99: CAD file, 2020-05-09]
SolidWorks/Soporte-Tama-Servo.SLDPRT
55.5 x 16.4 x 20.1 mm
