torosky92/ChrisV2/SolidWorks/Engranaje2-Garra.SLDPRT

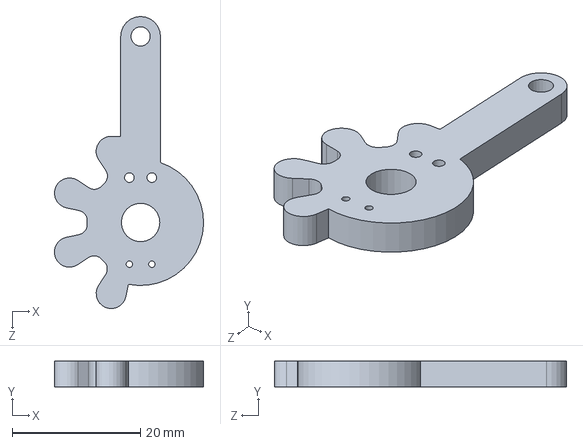
[picture p100: CAD file, 2020-05-09]
SolidWorks/Engranaje2-Garra.SLDPRT
23.2 x 4.00 x 45.5 mm
