torosky92/ChrisV2/SolidWorks/Eslabon2B.SLDPRT

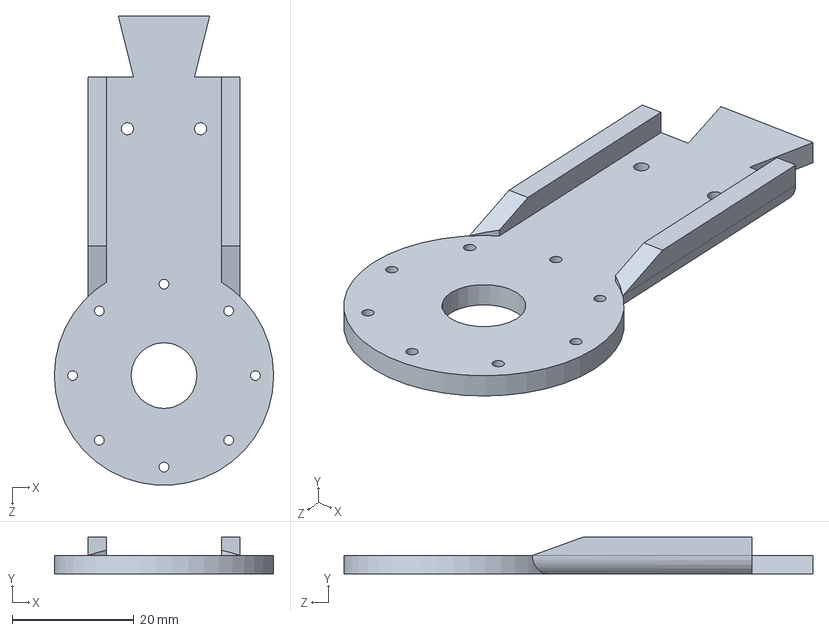
[picture p101: CAD file, 2020-05-09]
SolidWorks/Eslabon2B.SLDPRT
36.0 x 6.00 x 76.9 mm
