torosky92/ChrisV2/SolidWorks/Eslabon4C.SLDPRT

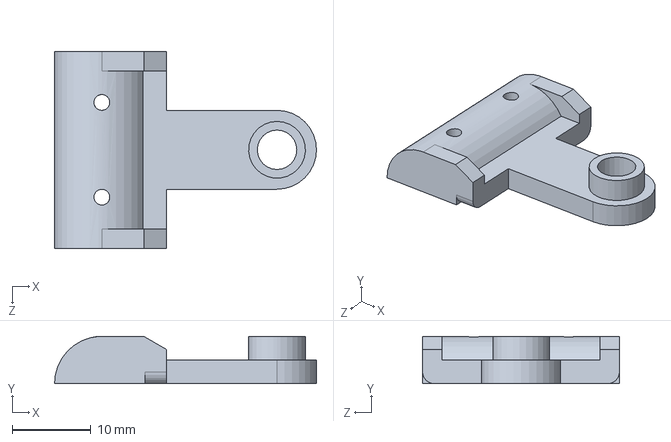
[picture p102: CAD file, 2020-05-09]
SolidWorks/Eslabon4C.SLDPRT
33.2 x 6.00 x 24.9 mm
