torosky92/ChrisV2/SolidWorks/Eslabon3C.SLDPRT

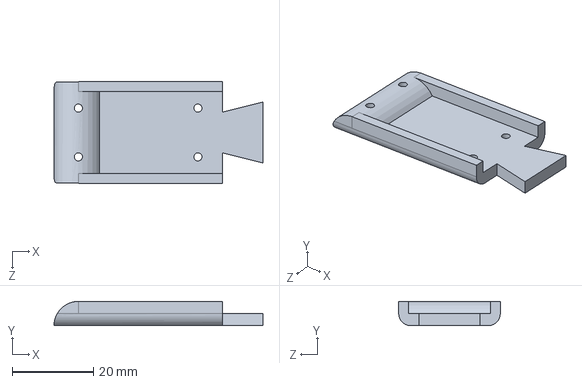
[picture p103: CAD file, 2020-05-09]
SolidWorks/Eslabon3C.SLDPRT
51.4 x 6.00 x 25.0 mm
