torosky92/ChrisV2/SolidWorks/Soporte-Garra.SLDPRT

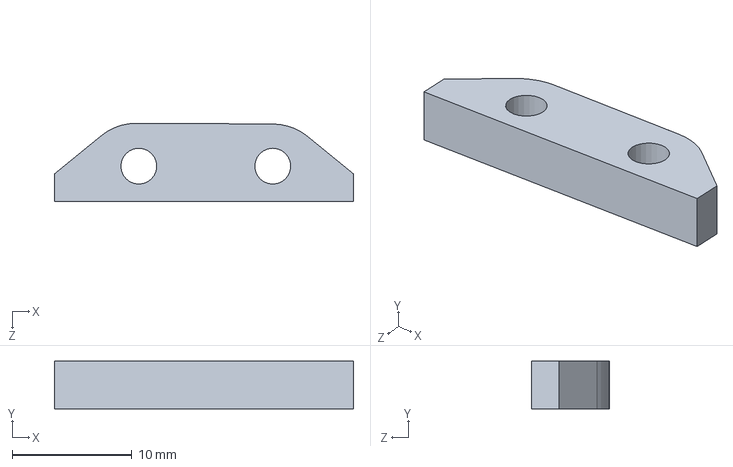
[picture p104: CAD file, 2020-05-09]
SolidWorks/Soporte-Garra.SLDPRT
25.0 x 4.00 x 6.56 mm
