torosky92/ChrisV2/SolidWorks/Engranaje-Garra.SLDPRT

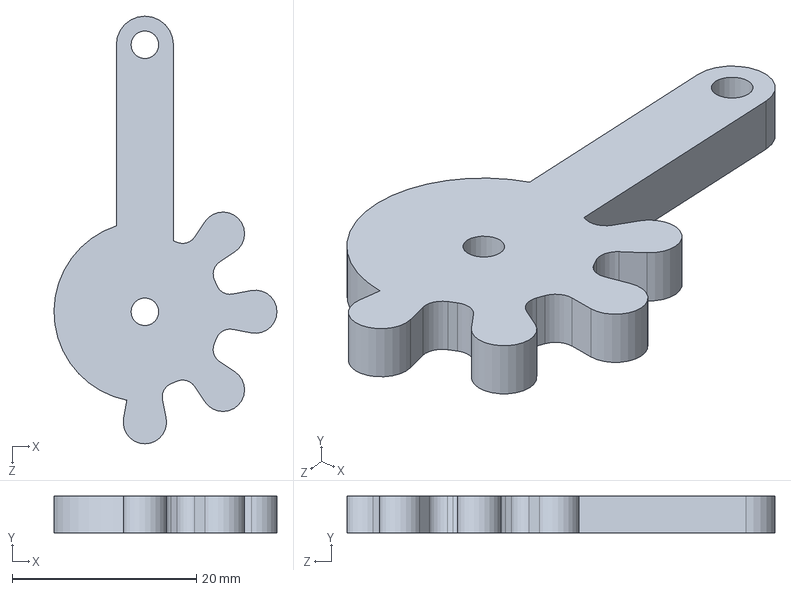
[picture p105: CAD file, 2020-05-09]
SolidWorks/Engranaje-Garra.SLDPRT
24.2 x 4.00 x 46.4 mm
