torosky92/ChrisV2/SolidWorks/Eslabon3E1.SLDPRT

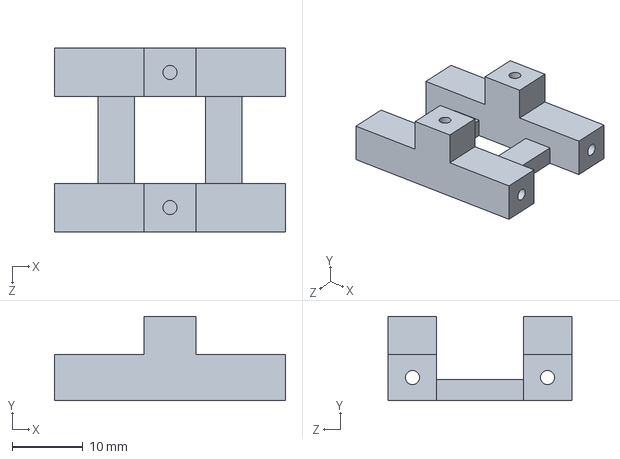
[picture p106: CAD file, 2020-05-09]
SolidWorks/Eslabon3E1.SLDPRT
32.7 x 11.9 x 26.0 mm
