torosky92/ChrisV2/SolidWorks/Eslabon5C.SLDPRT

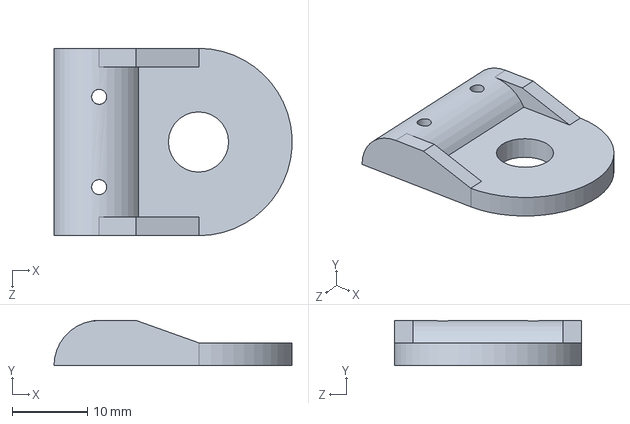
[picture p107: CAD file, 2020-05-09]
SolidWorks/Eslabon5C.SLDPRT
31.6 x 6.00 x 24.9 mm
