torosky92/ChrisV2/SolidWorks/Conexion-Eslabones2.SLDPRT

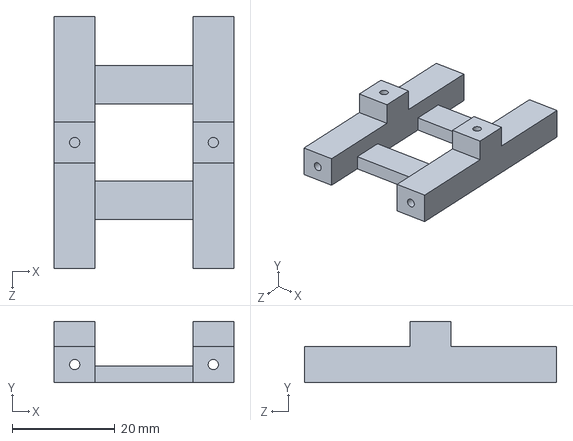
[picture p108: CAD file, 2020-05-09]
SolidWorks/Conexion-Eslabones2.SLDPRT
35.0 x 11.9 x 49.1 mm
