torosky92/ChrisV2/SolidWorks/Eslabon4B.SLDPRT

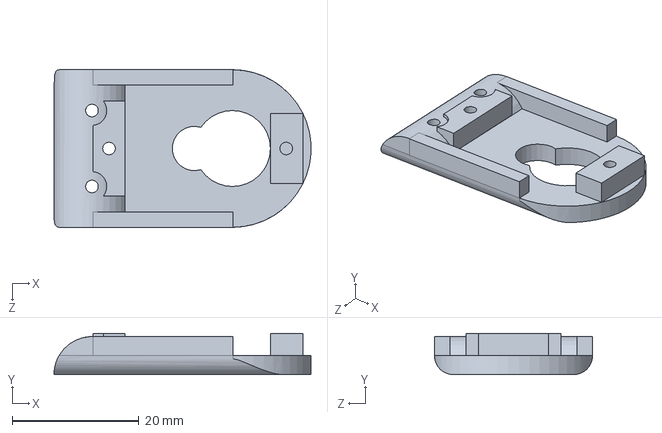
[picture p109: CAD file, 2020-05-09]
SolidWorks/Eslabon4B.SLDPRT
40.6 x 6.50 x 25.0 mm
