torosky92/ChrisV2/(list of files, cad)

Other CAD files:
SolidWorks/Eslabon5A-Servo.SLDPRT
