torosky92/ChrisV2/Tutorial/ROS Kinetic_Moveit_Serial.odt

ROS Brazo Robotico Chris

En la lectura de las estructuras en ROS es de formato URDF y si no sabes manejar bien Rviz te demoraras mucho tiempo en poder crear la estructura, por lo que se recomienda para tener el modelo de la estructura fisica en digital con SolidWorks, que a pesar del formato no sea compatible, en este se le puede instalar un parche al software para convertir, este parche se llama SW2URDF que se encuentra en el siguiente link http://wiki.ros.org/sw_urdf_exporter

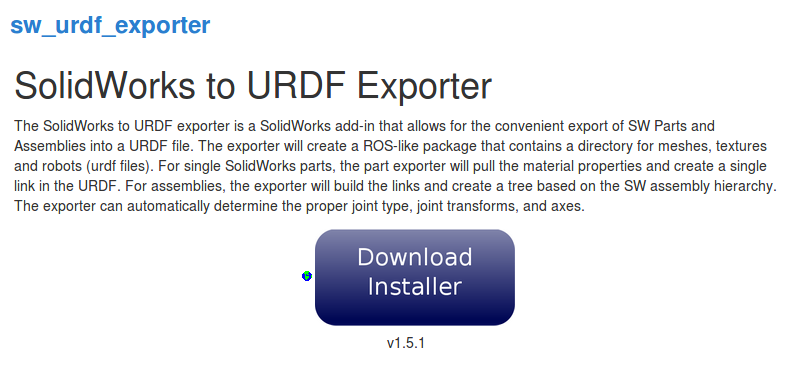
[picture p114: figure]

Al presionar Download Installer automáticamente se descarga un documento comprimido por lo que se debe extraer e instalar, si se instalo de forma correcta al abrir SolidWorks se debe activar la ventana de Export URDF, tal como se ve en la ilustración

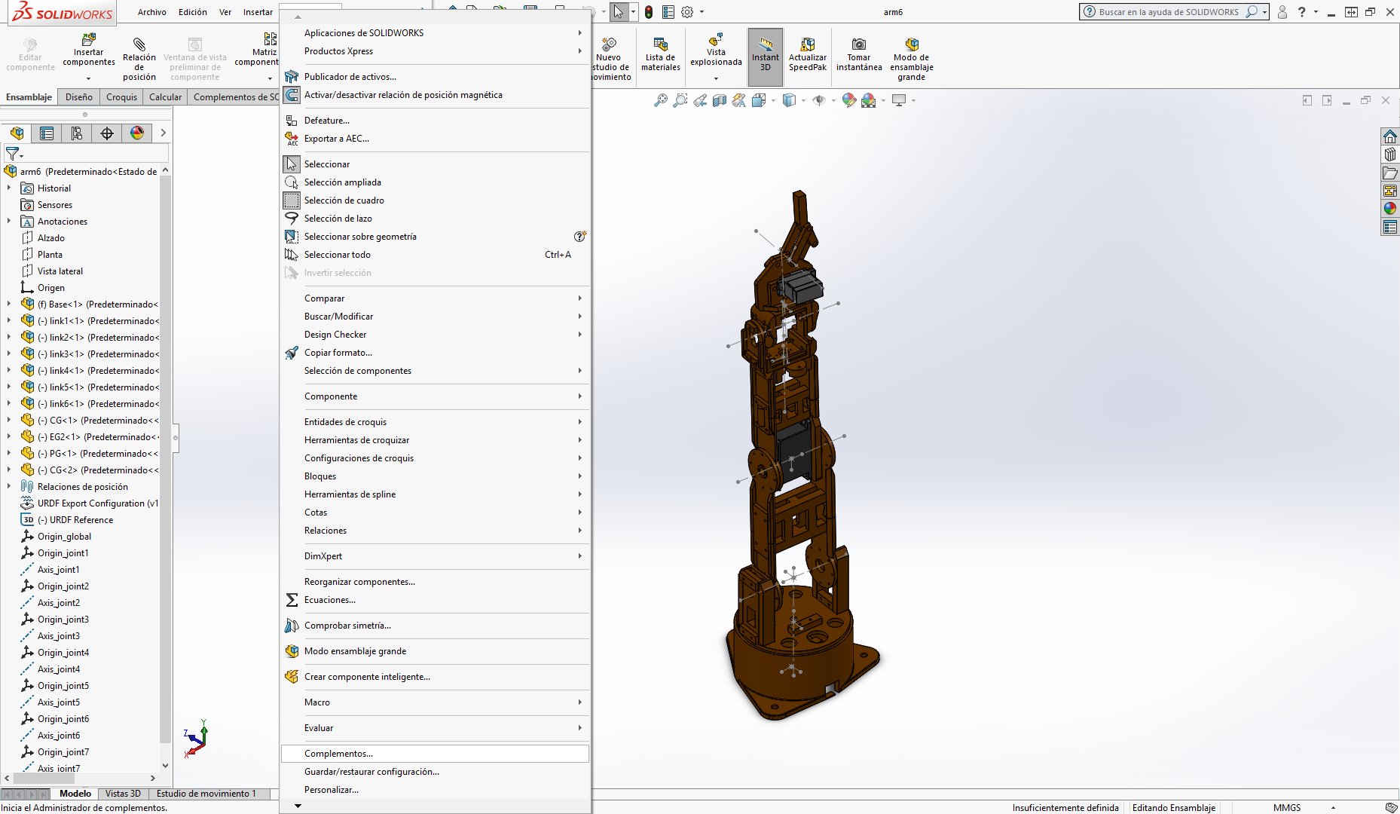
[picture p115: figure]
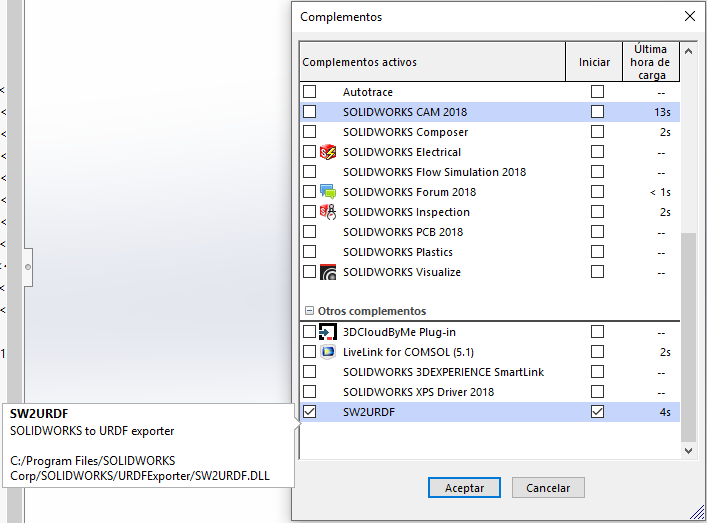
[picture p116: figure]

Ya activado debe aparecer en herramientas en la parte inferior de la lista lo siguiente:

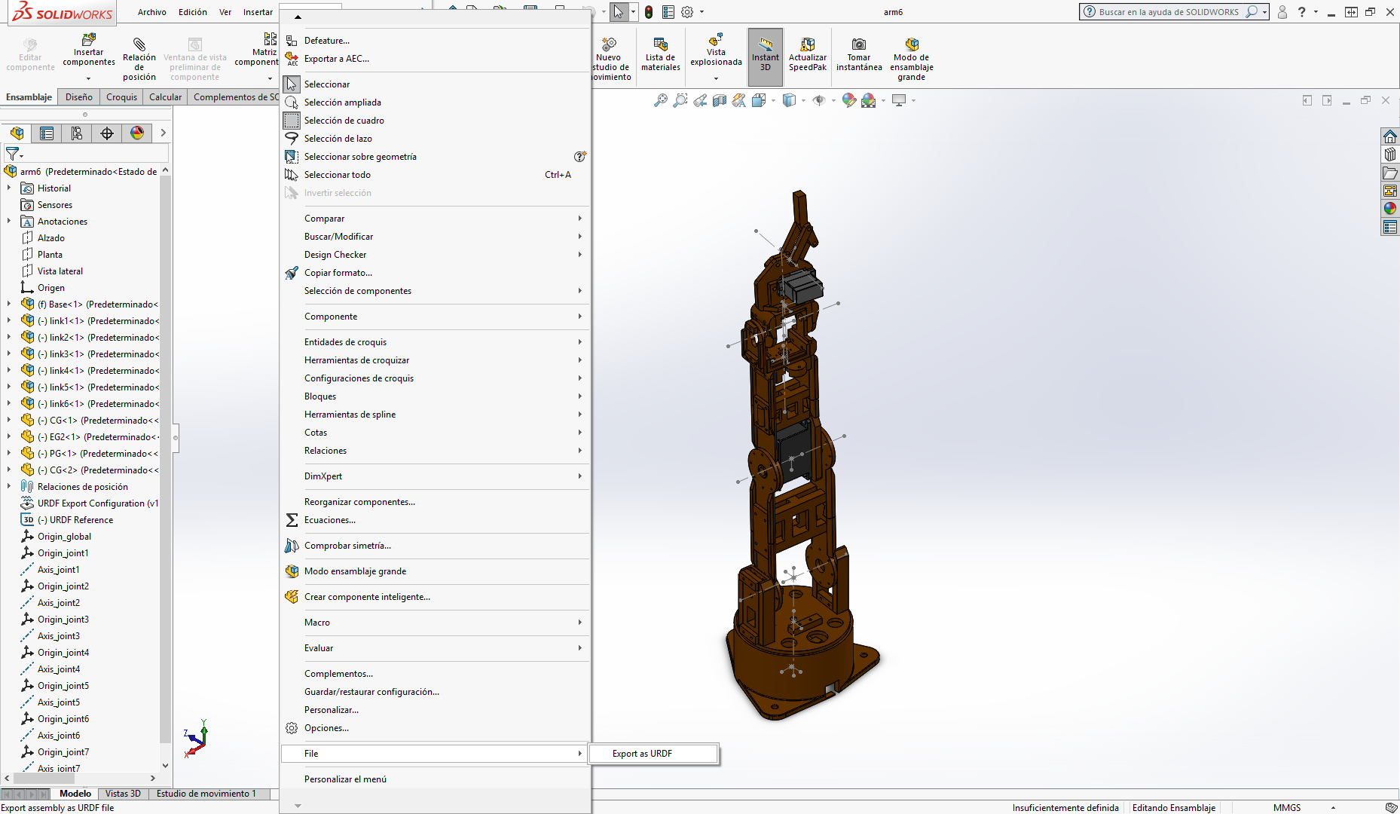
[picture p117: figure]

NOTA: El paso anterior se recomienda hacer después de tener todo el ensamble realizado al cual se recomienda no poner todos los detalles, como tornillos y/o motores, si no la estructura).

PASOS PARA EXPORTAR DE SOLIDWORKS A URDF (Versión SolidWorks 2018)

1. Organizar el ensamble colocando de primero la base en el eje (0, 0, 0)

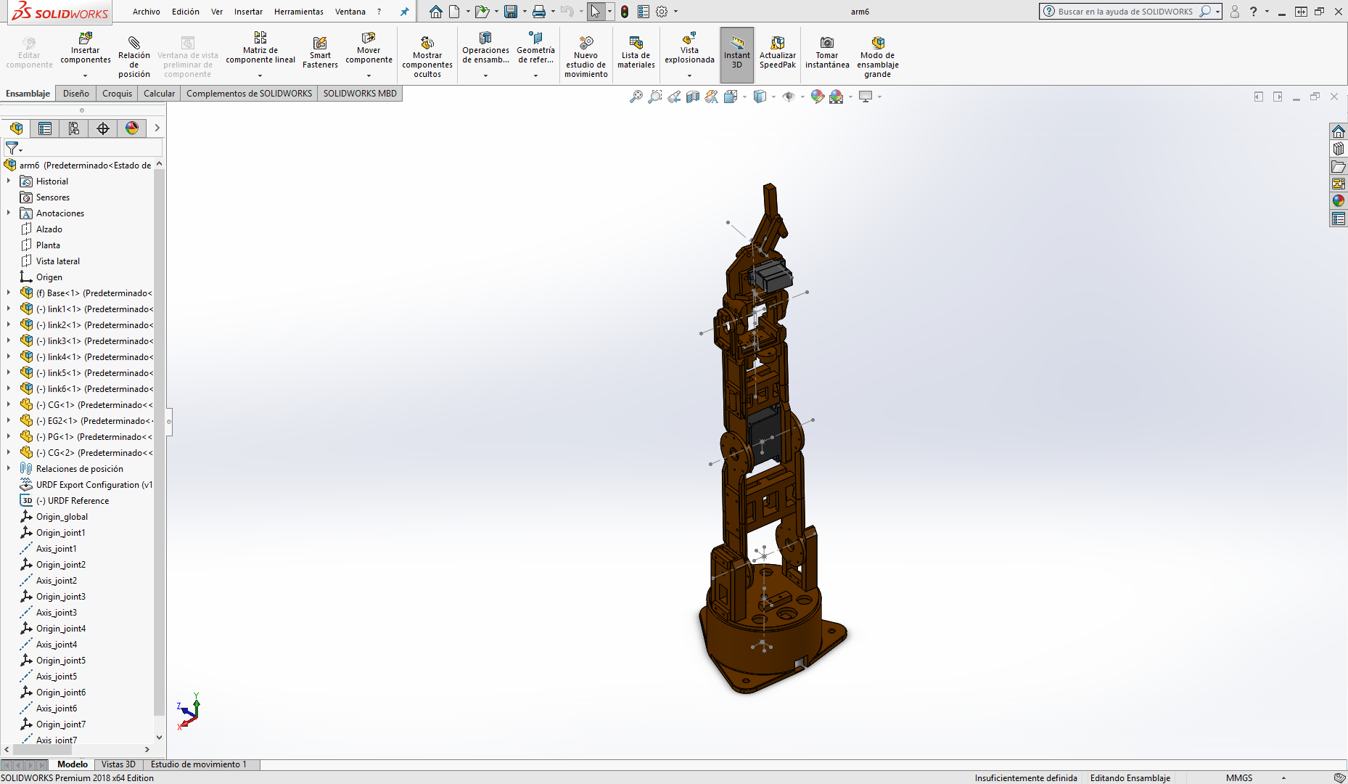
[picture p118: figure]

2. Presionamos en herramientas, buscamos en la lista File y se nos despliega una opción de Export as URDF, presionamos.
3. Luego de presionar nos aparece lo siguiente en el lateral izquierdo

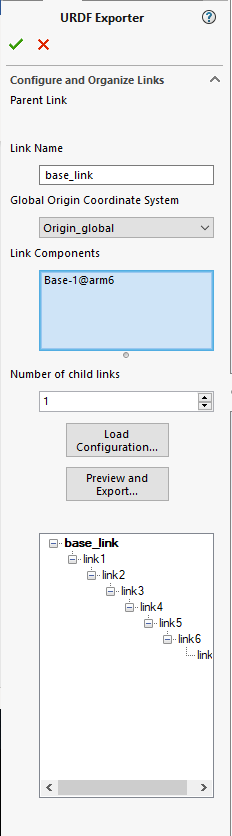
[picture p119: figure]

4. Llenamos todos los datos requeridos, primero la base por lo que la llamamos como lo podamos recordar fácilmente, en Link Components debemos de seleccionar la pieza del ensamble para el caso, después donde dice Number of child links pondremos quien sigue de nuestra base, es decir si es un carro tendríamos que poner de 2 ruedas, tenemos que poner 2, pero como es un brazo tenemos que poner 1, y esto abrirá en la lista la otra opción, la presionamos hasta que este en negrita.

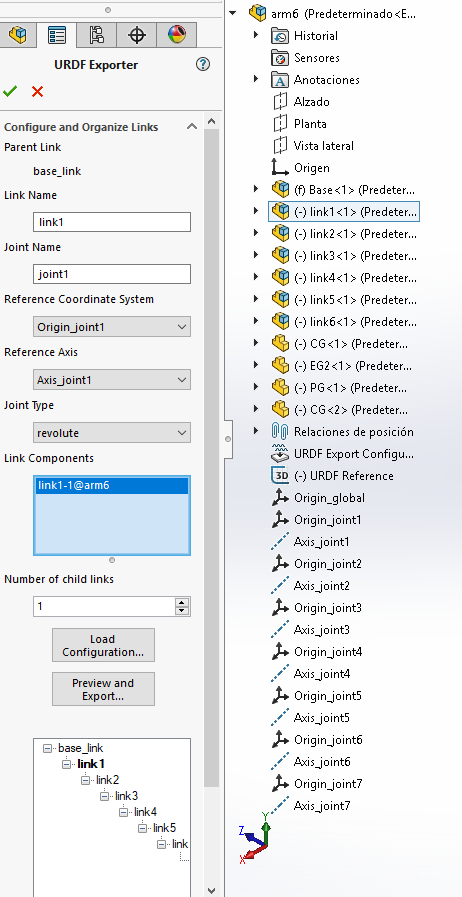
[picture p120: figure]

5. Es importante nombrar las articulaciones que une la pieza anterior con la actual, y se hace el mismo paso anterior, hasta que tengas todas las piezas adicionadas.
6. Se presiona en Preview and Export, el tarda un poco para poner los ejes de cada articulación y salga la siguiente ventana

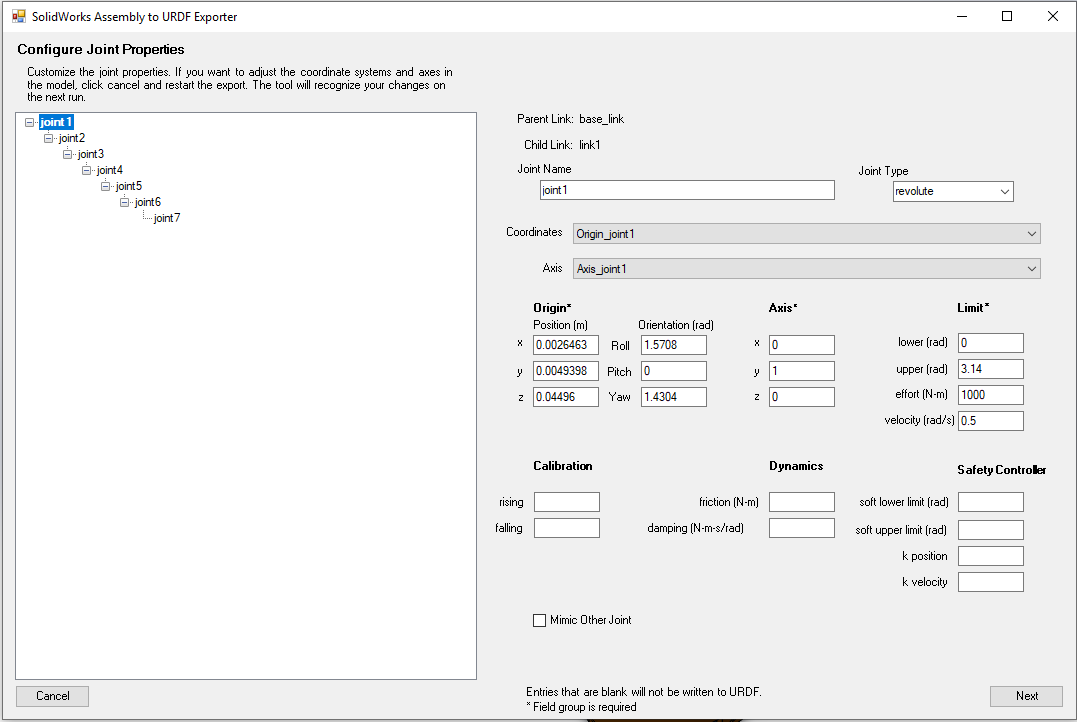
[picture p121: figure]

7. Debemos tener en cuenta que los datos que nos debe interesar son los siguientes:

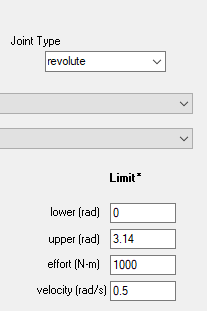
[picture p122: figure]

Donde Join Type es el tipo de articulación para nosotros es de revoluciones por ser servos, los limites es el comportamiento que debe tener el sistema, es decir, que no tenga colisiones.

8. Luego de completar lo anterior con cada articulación se presiona Next y nos saldrá otras opciones.

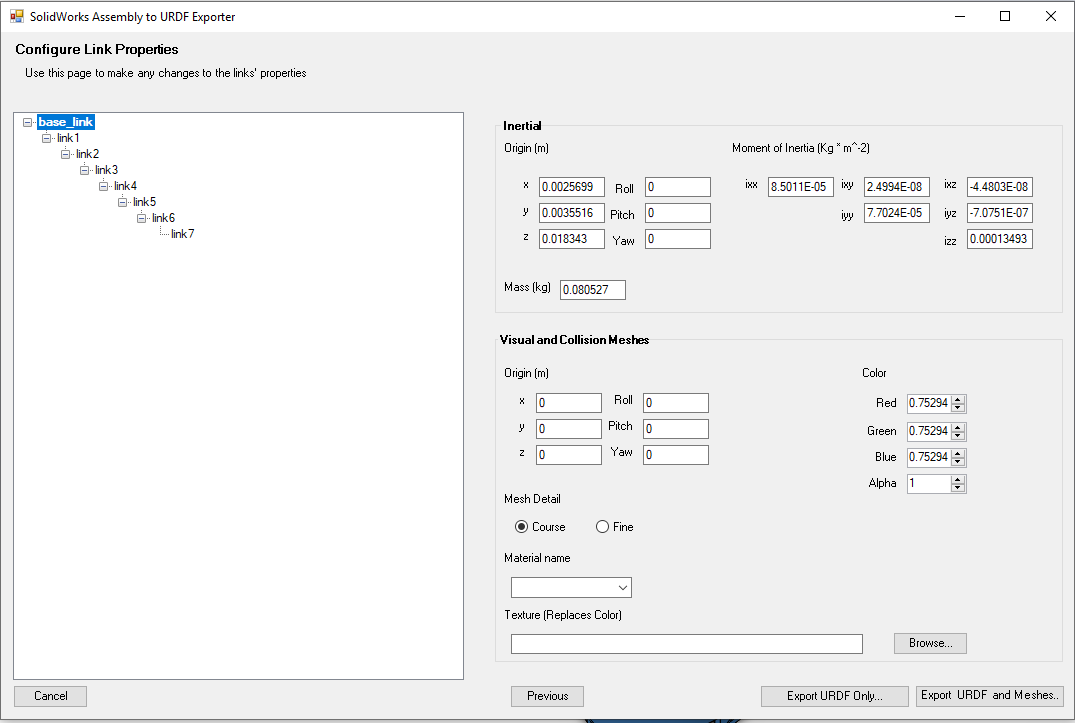
[picture p123: figure]

Donde podremos seleccionar el tipo de color de la figura, en este caso todas las dejamos en color gris claro (Por defecto) y luego se recomienda presionar el botón de Export URDF and Meshes.

9. Se guarda el archivo con el nombre del proyecto en el escritorio y se copia en una USB para pasarlo a Ubuntu.
10. Ya en Ubuntu se crea una carpeta de trabajo y dentro de ella se crea otra carpeta con el siguiente nombre src, dentro de ella se pega la carpeta que se copio de la USB.

PASO IMPORTANTE

Cuando se hace una modificación en la carpeta de trabajo se debe ejecutar el siguiente protocolo para su buen funcionamiento:

1. Dirigirse a la carpeta de trabajo en la terminal:

cd /<Dirección donde esta la carpeta de trabajo>/

2. Ejecutar el siguiente comando:

catkin_make

3. Ejecutar el segundo código:

source /<Dirección donde esta la carpeta de trabajo>/devel/setup.bash

4. (Opcional) Ejecutar el siguiente código:

catkin_make install

Luego de guardar los archivos, estos deben de llevarse al área de trabajo de ROS, antes de trabajar todo el sistema con MOVEIT! Se recomienda probar en urdf_tutorial. Realizando los siguientes pasos:

1. Limpiar librería (Desistalando) con el siguiente código:

sudo apt-get remove ros-kinetic-urdf-tutorial

2. Instalamos la librería con el siguiente código:

sudo apt-get install ros-kinetic-urdf-tutorial

3. Dirigirse a la carpeta de URDF que exportaste tal como se ve en el siguiente Código en la terminal:

cd /<Dirección donde esta la carpeta de trabajo>/src/urdf/

4. Luego vemos que archivos tenemos en esa carpeta:

ls

5. Seleccionamos todos los archivos y los copiamos con CTRL+SHIFT+C y lo pegamos sobre el espacio que dice <Archivos que se desean pasar> del siguiente código.

sudo cp <Archivos que se desean pasar> /opt/ros/kinetic/share/urdf_tutorial/meshes/

6. El mismo proceso se hace pero en la carpeta de meshes

cd /<Dirección donde esta la carpeta de trabajo>/src/meshes/

ls

sudo cp <Archivos que se desean pasar> /opt/ros/kinetic/share/urdf_tutorial/meshes/

7. Ya que se pasaron los archivos, ejecutamos el siguiente código que activara el entorno de Rviz

roslaunch urdf_tutorial display.launch model:=<Nombre del archivo que se exporto>.urdf

8. Se abre el entorno 3D y se hace las pruebas de colisión, si se ve que el movimiento del brazo puede colisionar se da dos opciones, la primera es modificar desde el código (.urdf) o en el ensamble que se tiene en SolidWorks se modifica.
9. Si no se tiene instalado MOVEIT! Ejecute el siguiente código:

sudo apt install ros-kinetic-moveit

10. Teniendo lo anterior sin colisiones se ejecuta MOVEIT! Con el siguiente código:

roslaunch moveit_setup_assistant setup_assistant.launch

Este abre el área de trabajo MOVEIT!

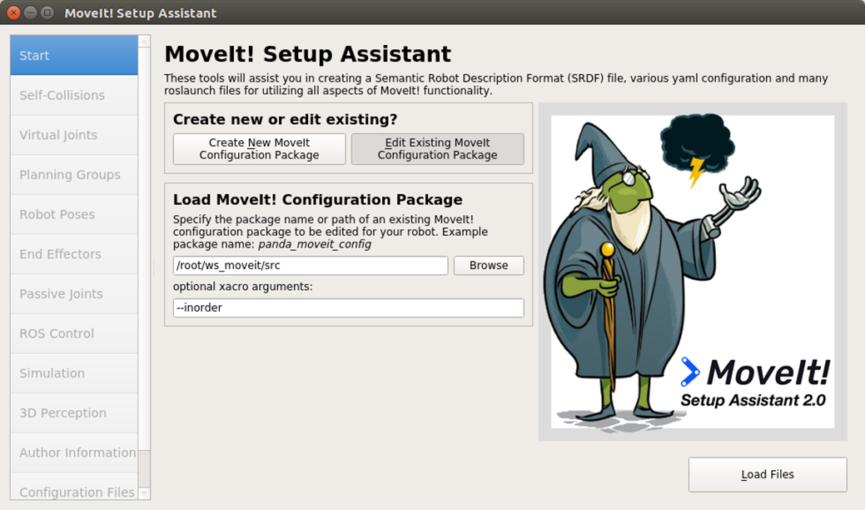
[picture p124: figure]

11. Se pone nuevo MOVEIT! Y se busca el archivo URDF que se hizo el correcto análisis de colisión.

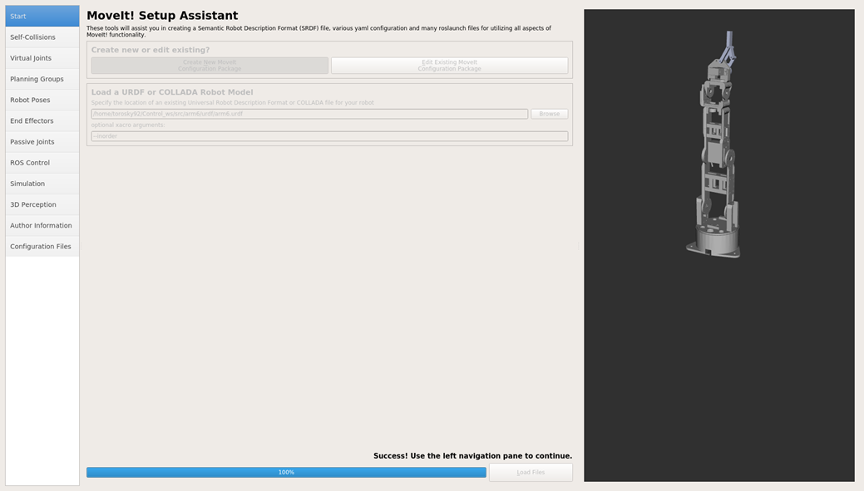
[picture p125: figure]

12. Seleccionamos la casilla Self-Collisions y presionamos automático

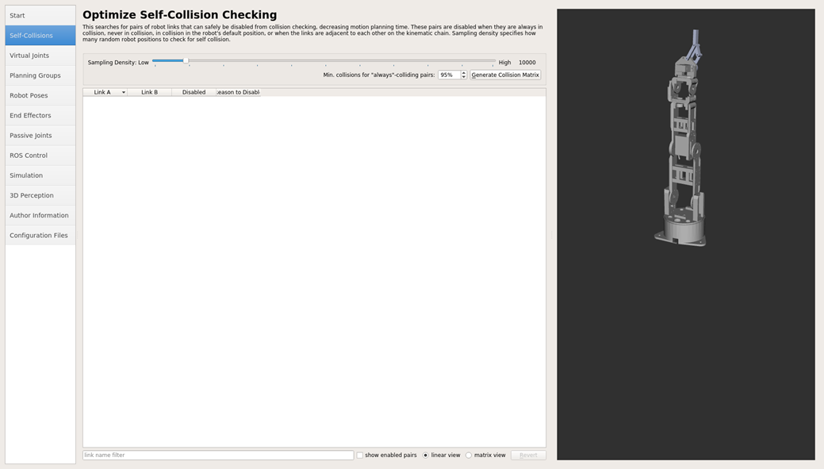
[picture p126: figure]
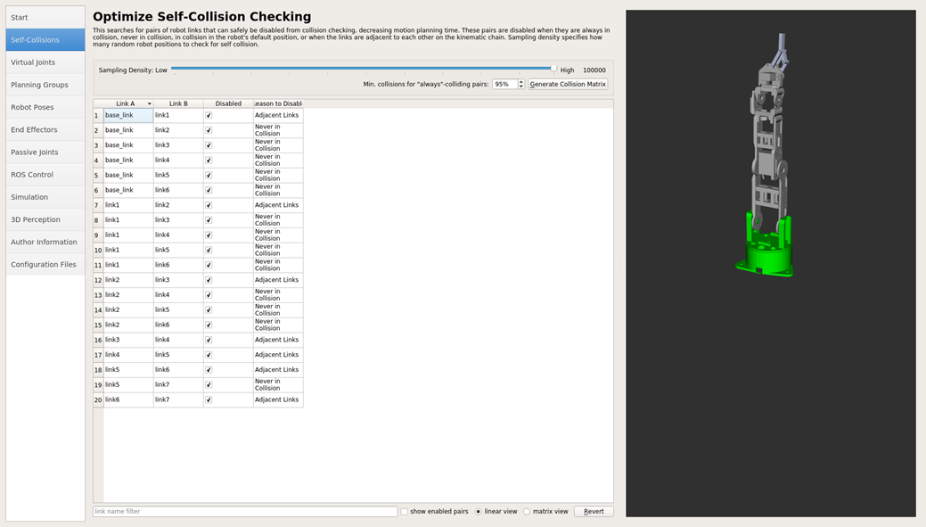
[picture p127: figure]

13. Adicionamos las dependencias virtuales con el fin de conectarlo con la realidad

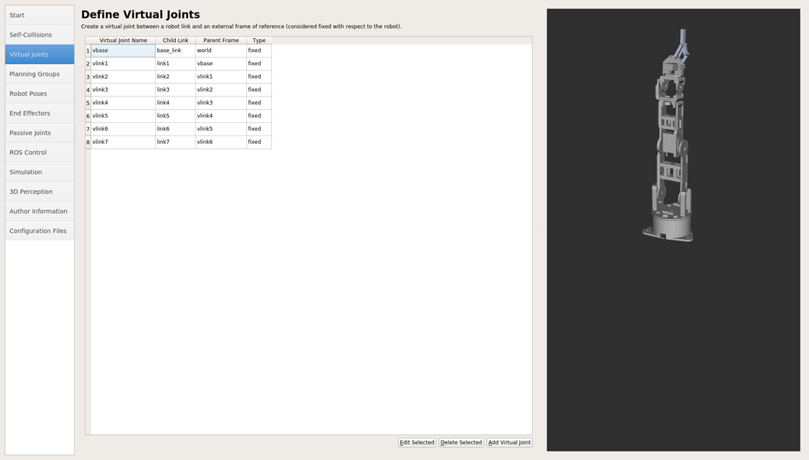
[picture p128: figure]

14. Se selecciona el planteamiento en grupos en nuestro caso son dos la mano y la garra

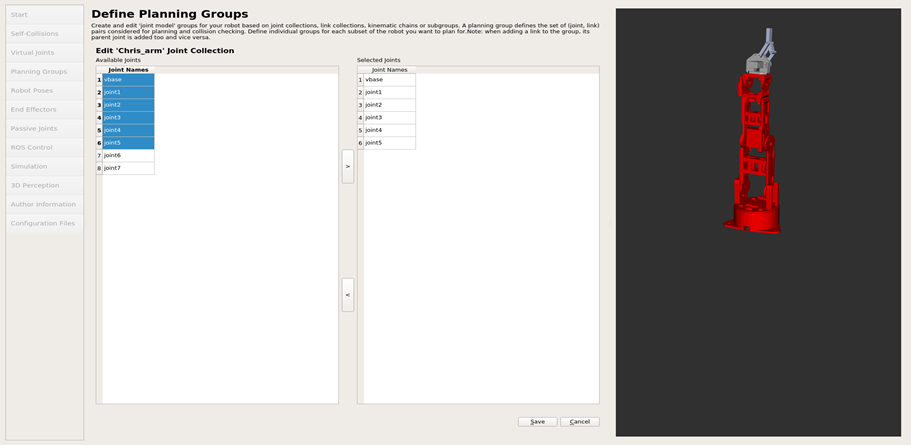
[picture p129: figure]
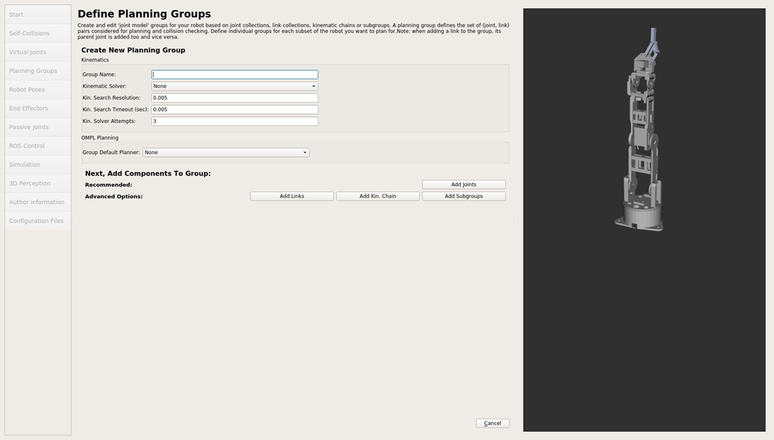
[picture p130: figure]

Primero agregaremos el brazo Chris como grupo de planificación

Ingrese el nombre del grupo como chris_arm

Elija kdl_kinematics_plugin / KDLKinematicsPlugin como el solucionador de cinemática.

Nota: si tiene un robot personalizado y desea un potente solucionador IK personalizado, consulte Cinemática / IKFast

Deja que Kin. Resolución de búsqueda y Kin. El tiempo de espera de búsqueda se mantiene en sus valores predeterminados.

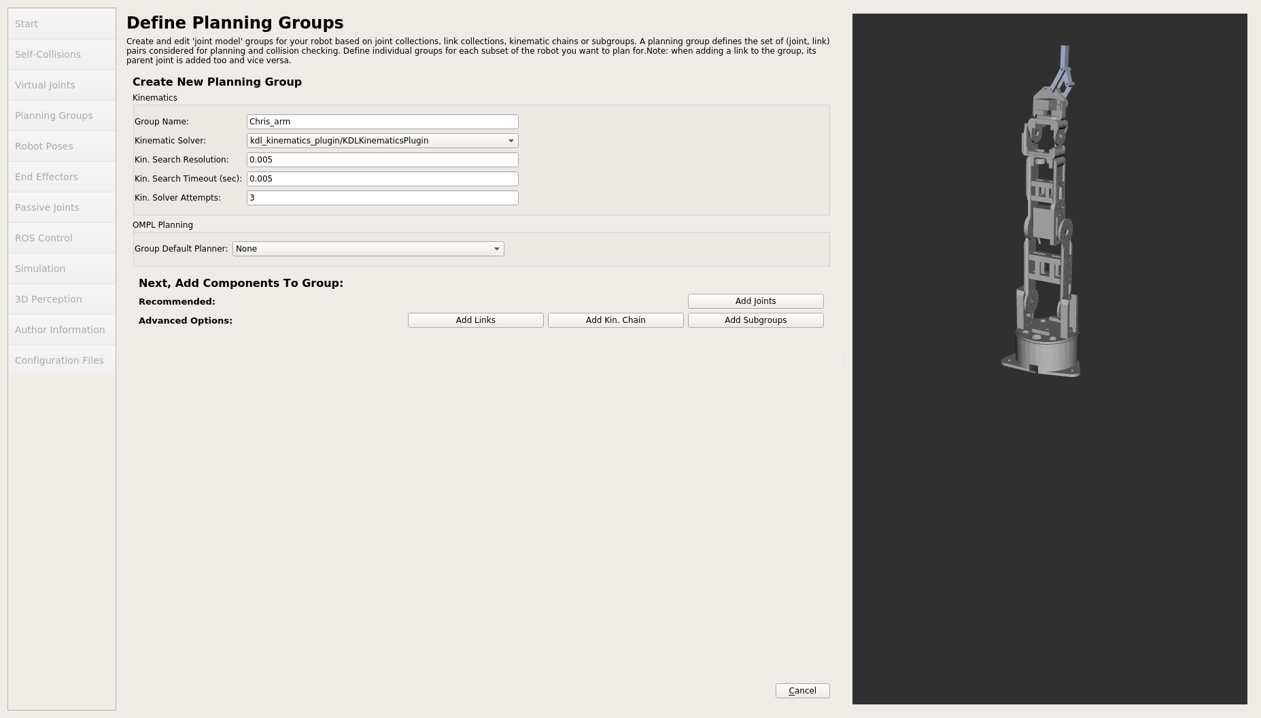
[picture p131: figure]
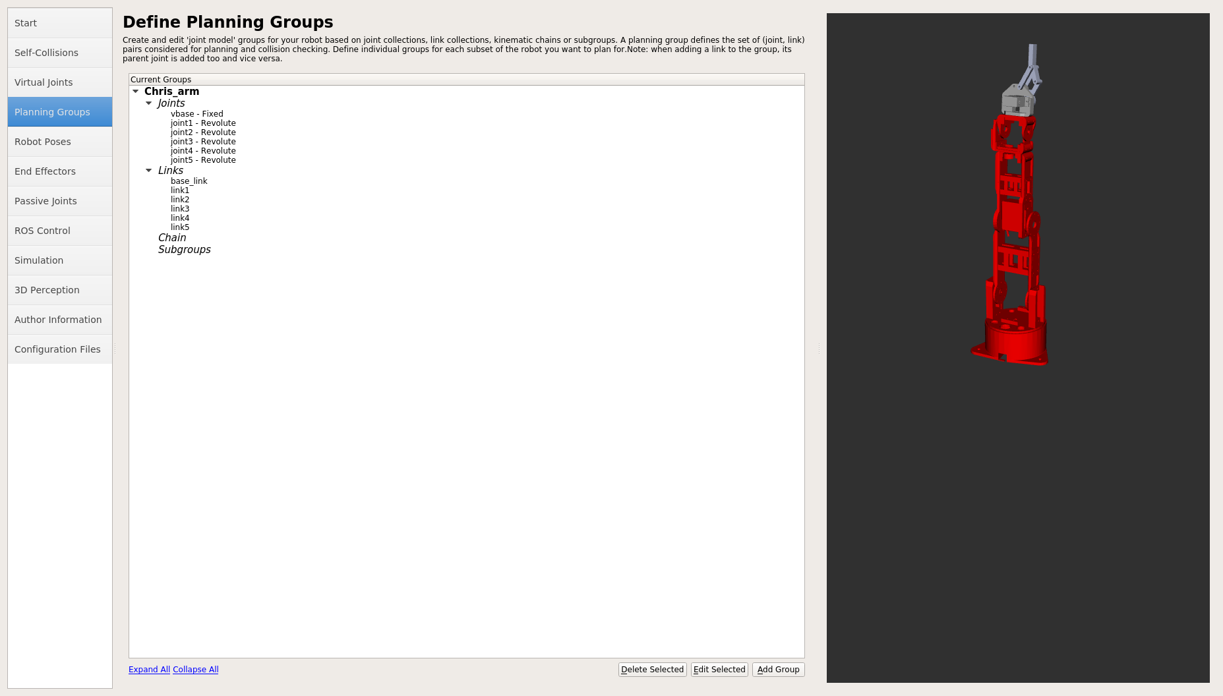
[picture p132: figure]

15. Adicionamos las poses del brazo robotico

Haga clic en el panel Poses del robot.

Haz clic en Agregar pose. Elige un nombre para la pose. El robot estará en su posición predeterminada, donde los valores de la articulación se establecen en el rango medio del rango de valores de la articulación permitido. Mueve las articulaciones individuales hasta que estés feliz y luego guarda la pose. Tenga en cuenta cómo las poses se asocian con grupos particulares. Puede guardar poses individuales para cada grupo.

CONSEJO IMPORTANTE: Intente mover todas las articulaciones. Si hay algo mal con los límites conjuntos en su URDF, debería poder verlo inmediatamente aquí.

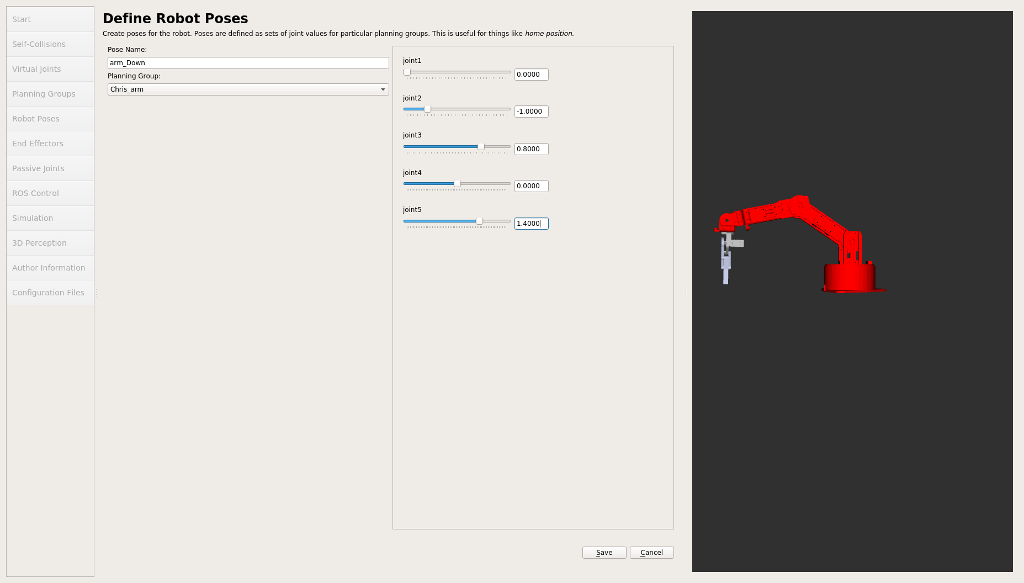
[picture p133: figure]

16. Efecto final para este seleccionamos la garra, designando a este grupo como un grupo especial:

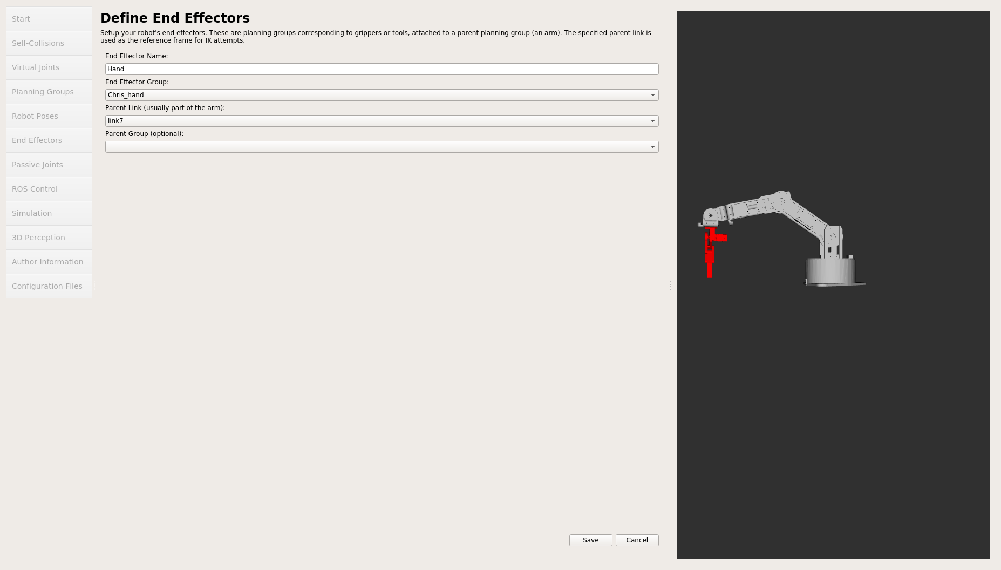
[picture p134: figure]

17. Percepción 3D

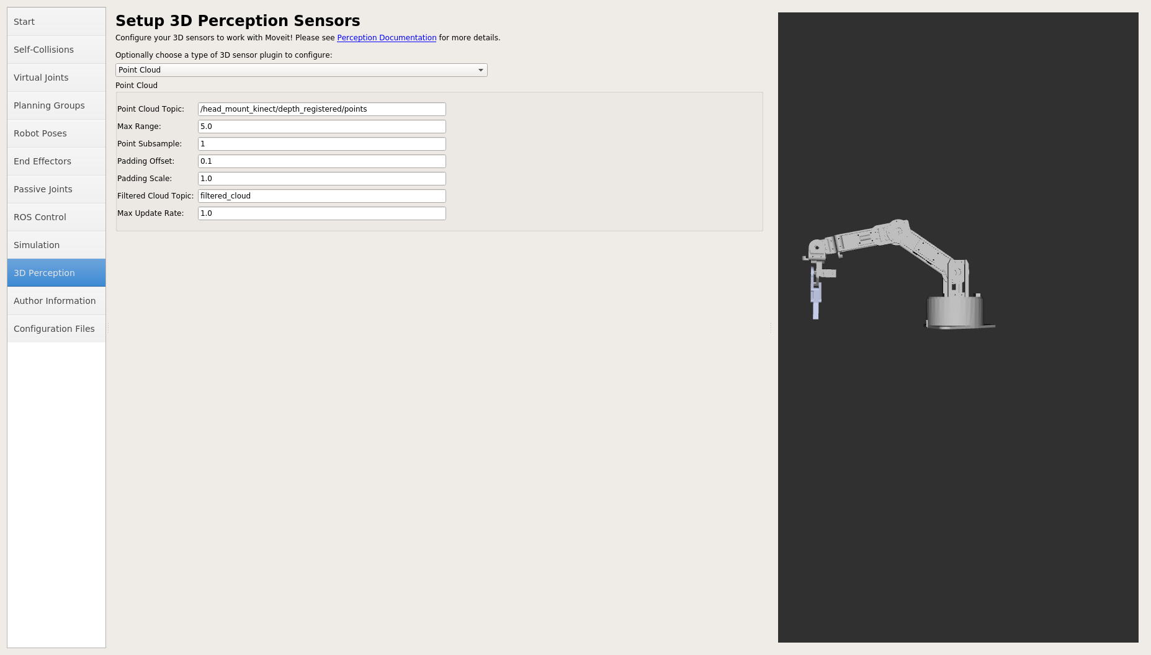
[picture p135: figure]

Para mayor información de los parámetros busca en el siguiente link http://docs.ros.org/kinetic/api/moveit_tutorials/html/doc/perception_pipeline/perception_pipeline_tutorial.html

En caso de no necesitar los sensores, elige la opción None.

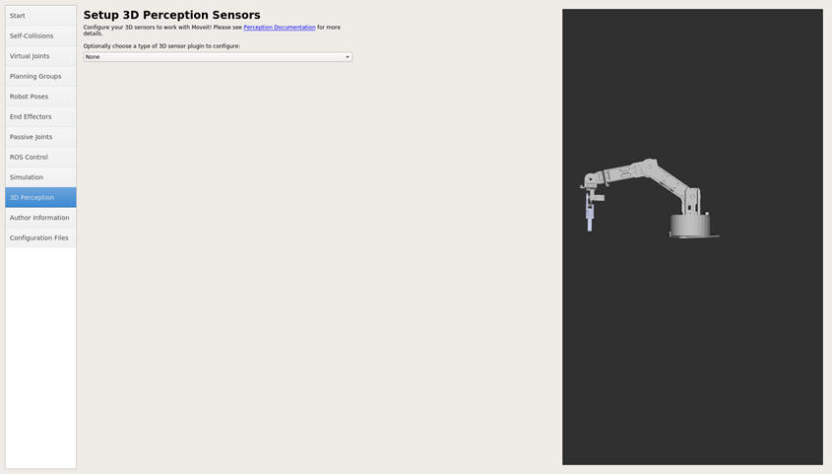
[picture p136: figure]

18. Si se quiere simular en Gazebo presione Generate Urdf

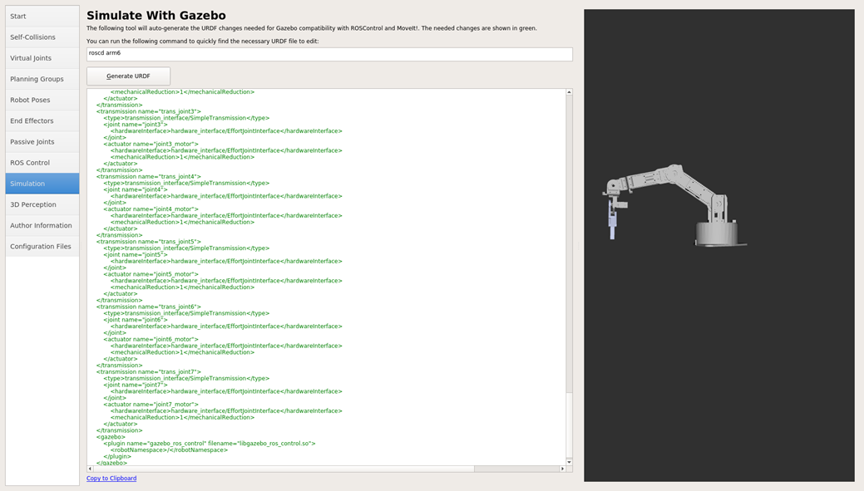
[picture p137: figure]

19. ROS control

ROS Control es un conjunto de paquetes que incluyen interfaces de controlador, administradores de controlador, transmisiones y interfaces de hardware, para más detalles, consulte la documentación de control de ROS (http://wiki.ros.org/ros_control)

La pestaña Control de ROS se puede usar para generar automáticamente controladores simulados para accionar las uniones de su robot. Esto nos permitirá proporcionar las interfaces ROS correctas MOVEIT!.

Haga clic en el selector del panel de control de ROS.

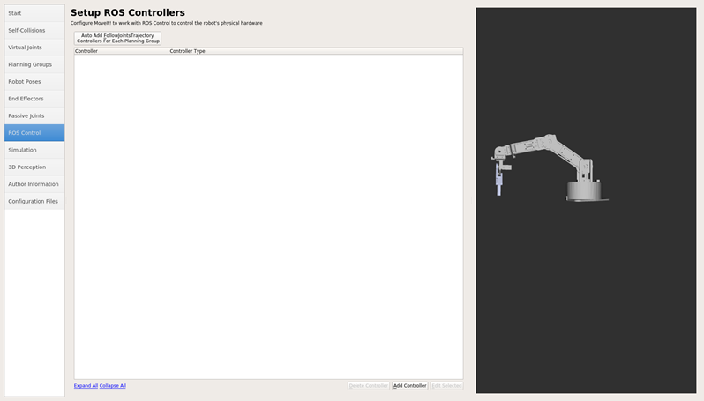
[picture p138: figure]

Haga clic en Agregar controlador y debería ver la siguiente pantalla:

Primero agregaremos el controlador de posición del brazo Panda

Ingrese el nombre del controlador como arm_position_controller

Elija position_controllers / JointPositionController como tipo de controlador

A continuación, debe elegir las uniones de este controlador, puede agregar uniones individualmente o agregar todas las uniones en un grupo de planificación todos juntos.

Ahora, haga clic en Agregar uniones de grupo de planificación.

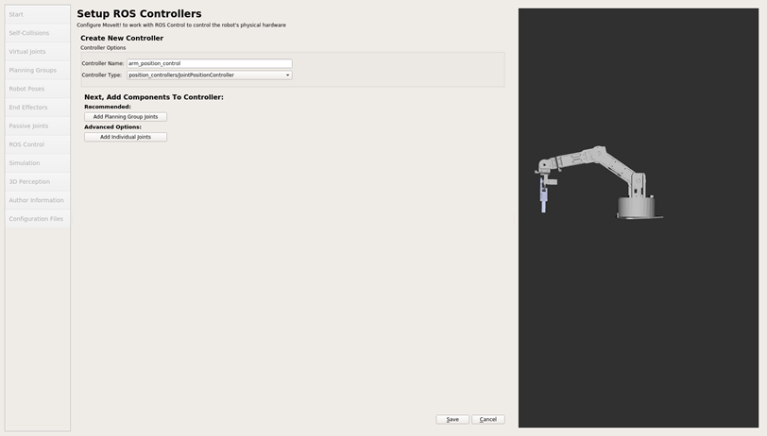
[picture p139: figure]

20. Añade tu información (Nombre de autor y correo)

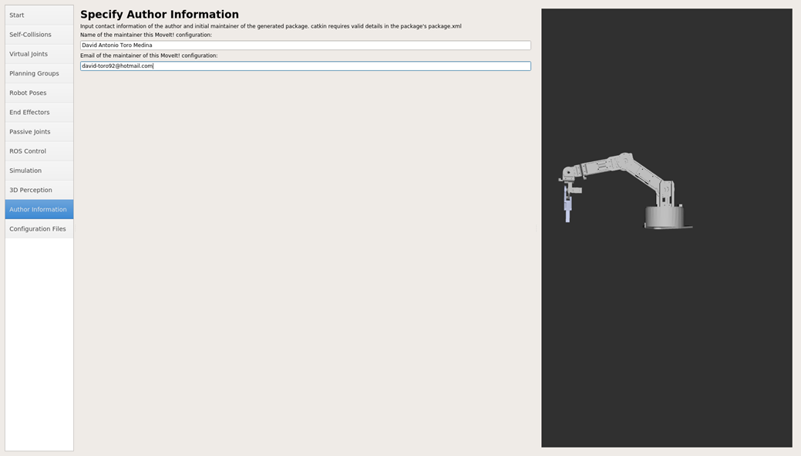
[picture p140: figure]

21. Y extraer en la carpeta deseada

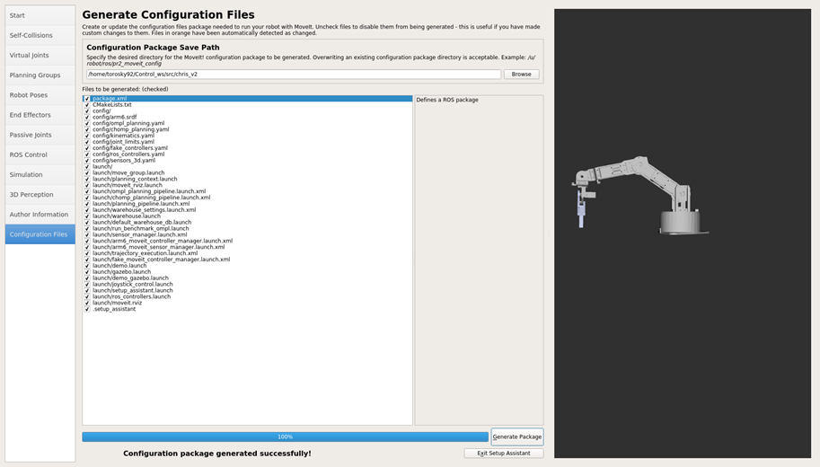
[picture p141: figure]

22. Se hace una prueba con el siguiente código:

roslaunch <Nombrechris_v1 demo.launch rviz_tutorial:=true

Debe parecer algo así.

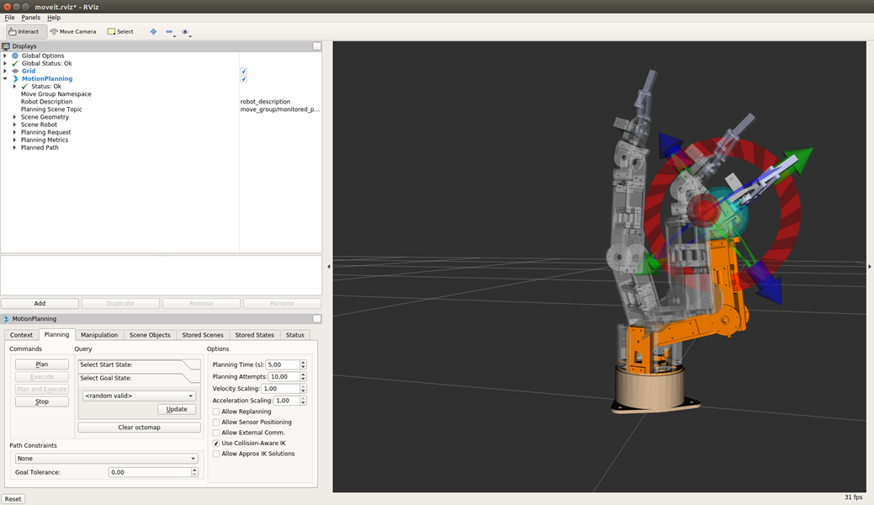
[picture p142: figure]

23. Para conectar el Arduino con el ROS

ls -l /dev/ttyACM*

sudo chmod -R 777 /dev/ttyACM*

rosrun rosserial_python serial_node.py _port:=/dev/ttyACM0 _baud:=115200
